Nocudo/Pendulo-Furuta-Control-Digital/cad/01_pendulo_furuta/renders/render_corte_articulacion.png

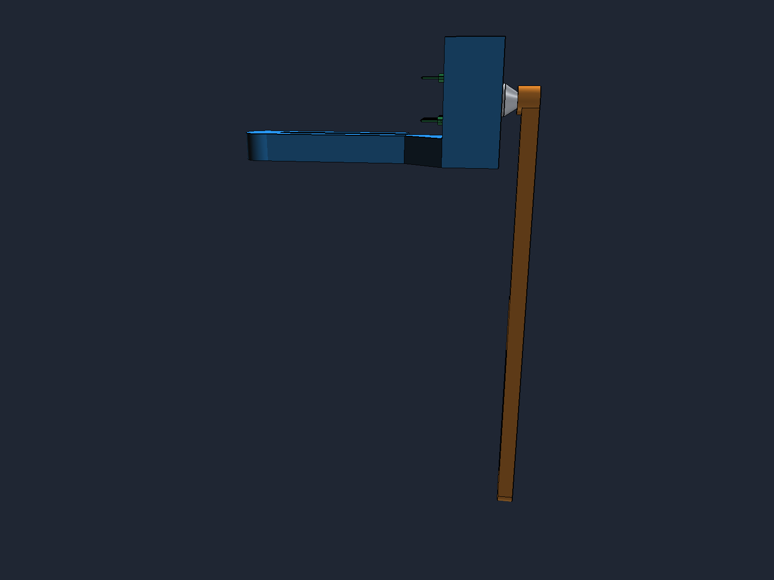
cad/01_pendulo_furuta/renders/render_corte_articulacion.png
