Nocudo/Pendulo-Furuta-Control-Digital/cad/01_pendulo_furuta/renders/render_corte_torre_motor.png

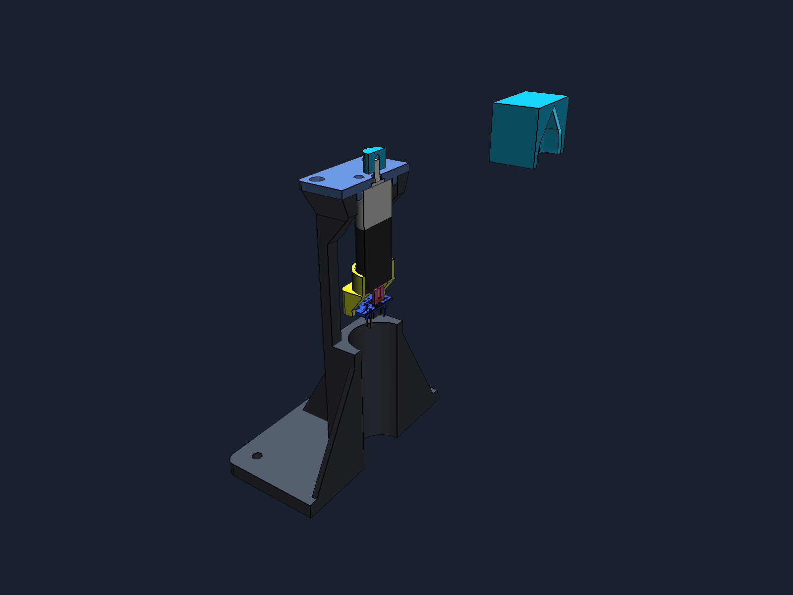
cad/01_pendulo_furuta/renders/render_corte_torre_motor.png
