Nocudo/Pendulo-Furuta-Control-Digital/cad/01_pendulo_furuta/renders/render_despiece_furuta.png

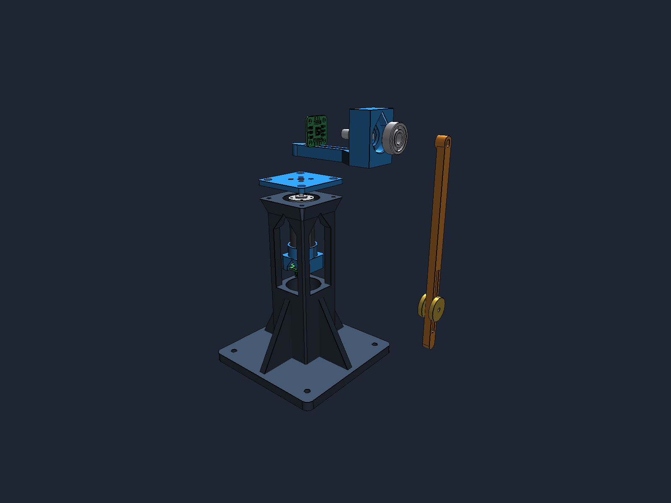
cad/01_pendulo_furuta/renders/render_despiece_furuta.png
