Nocudo/Pendulo-Furuta-Control-Digital/cad/01_pendulo_furuta/renders/render_detalle_acople_motor.png

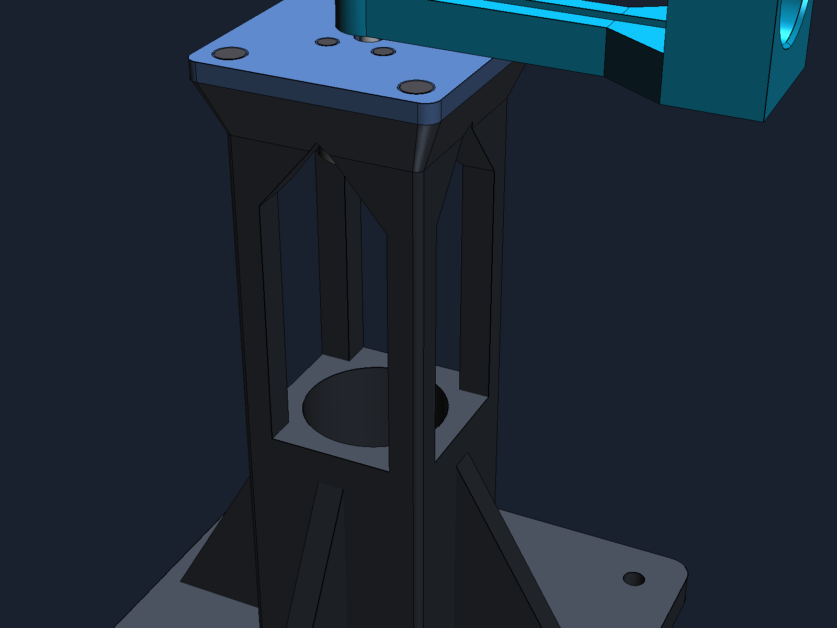
cad/01_pendulo_furuta/renders/render_detalle_acople_motor.png
