Nocudo/Pendulo-Furuta-Control-Digital/cad/01_pendulo_furuta/renders/render_detalle_articulacion.png

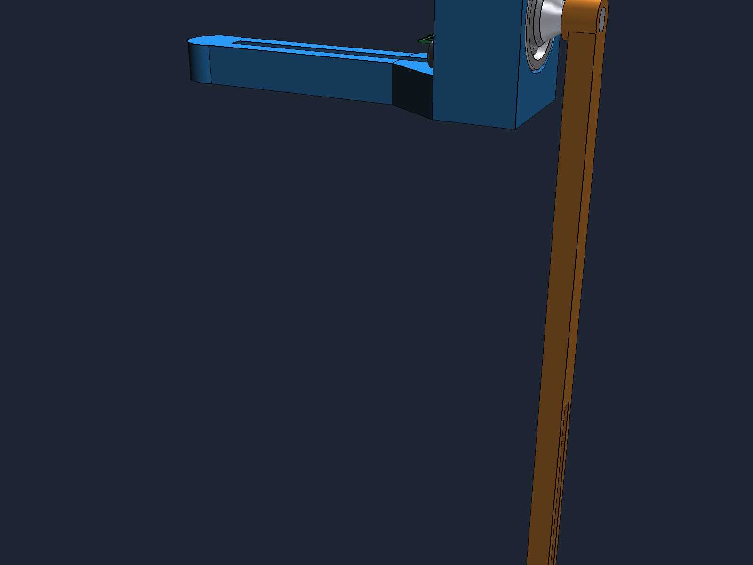
cad/01_pendulo_furuta/renders/render_detalle_articulacion.png
