Nocudo/Pendulo-Furuta-Control-Digital/cad/01_pendulo_furuta/renders/render_detalle_sensor_pendulo.png

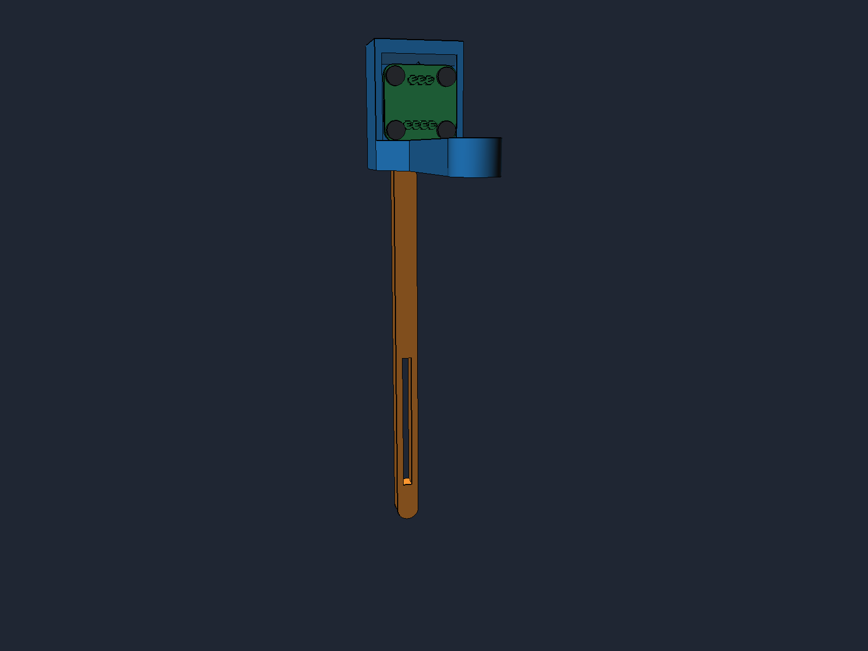
cad/01_pendulo_furuta/renders/render_detalle_sensor_pendulo.png
