Nocudo/Pendulo-Furuta-Control-Digital/cad/01_pendulo_furuta/renders/render_pendulo_furuta_completo.png

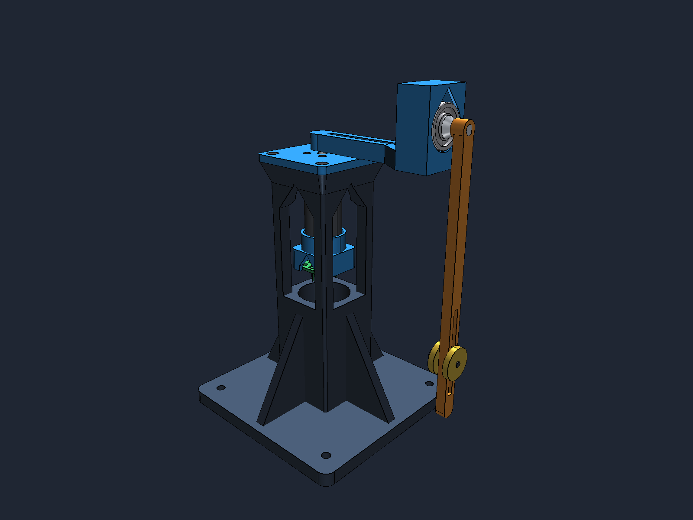
cad/01_pendulo_furuta/renders/render_pendulo_furuta_completo.png
