Nocudo/Pendulo-Furuta-Control-Digital/cad/01_pendulo_furuta/renders/render_vista_lateral.png

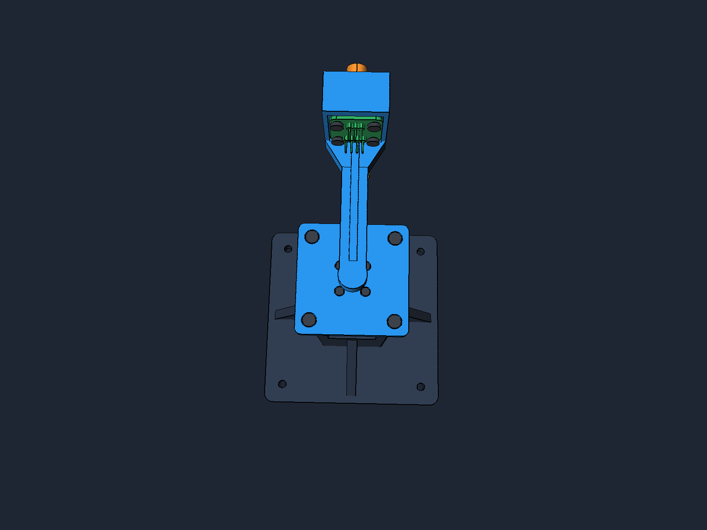
cad/01_pendulo_furuta/renders/render_vista_lateral.png
