Nocudo/Pendulo-Furuta-Control-Digital/cad/01_pendulo_furuta/renders/render_vista_lateral_completa.png

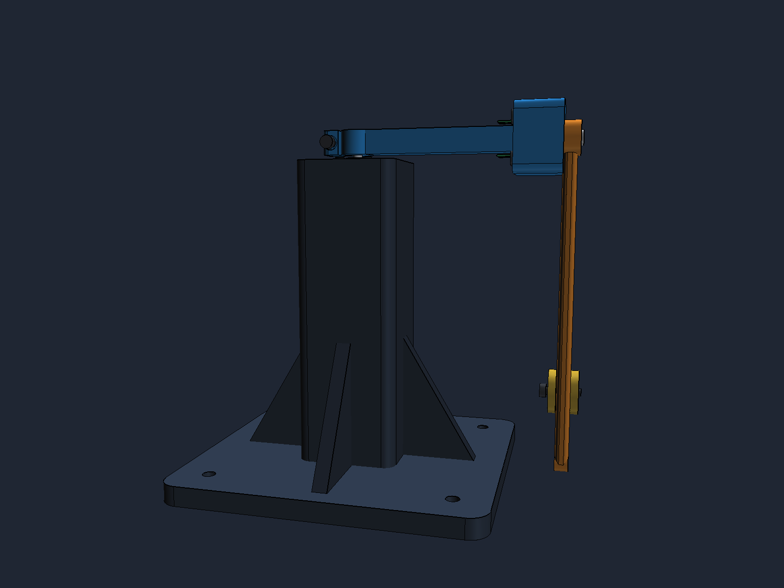
cad/01_pendulo_furuta/renders/render_vista_lateral_completa.png
