Nocudo/Pendulo-Furuta-Control-Digital/cad/02_motor_namiki_as5600/renders/render_acoplador_3d.png

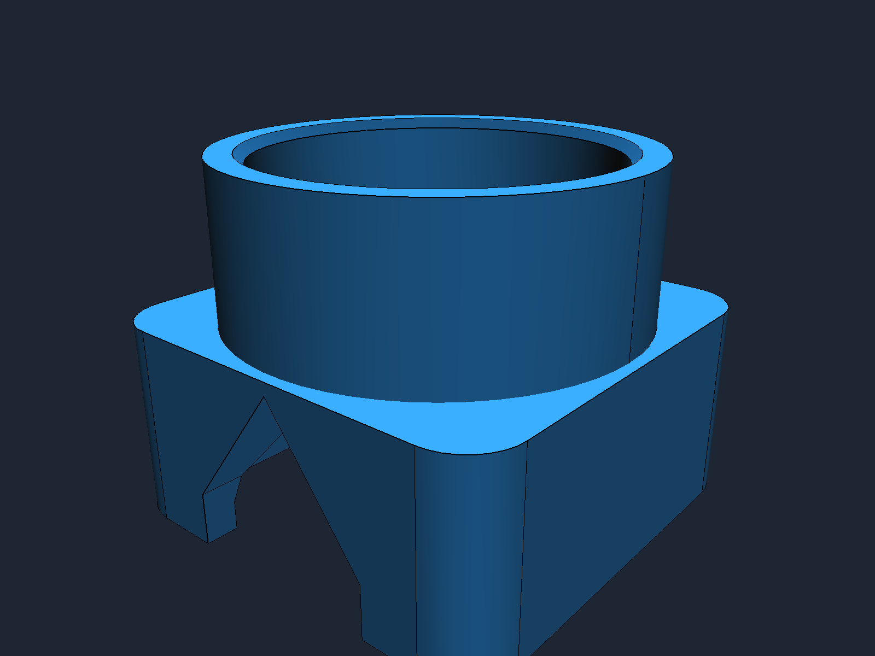
cad/02_motor_namiki_as5600/renders/render_acoplador_3d.png
