Nocudo/Pendulo-Furuta-Control-Digital/cad/02_motor_namiki_as5600/renders/render_corte_transversal.png

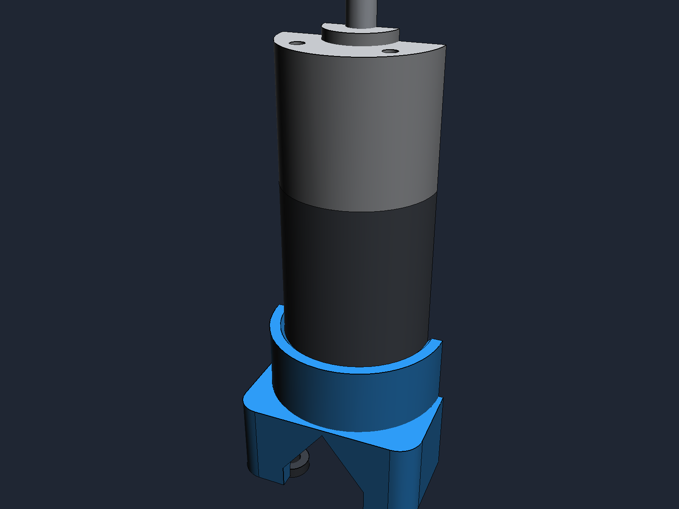
cad/02_motor_namiki_as5600/renders/render_corte_transversal.png
