Nocudo/Pendulo-Furuta-Control-Digital/cad/02_motor_namiki_as5600/renders/render_vista_inferior_pcb.png

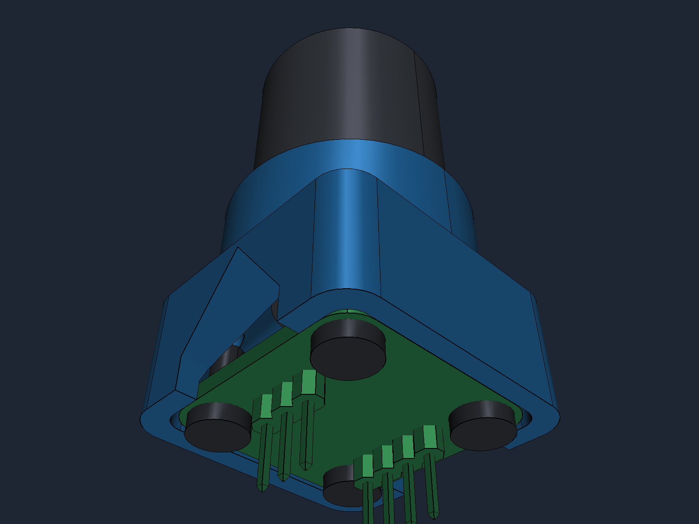
cad/02_motor_namiki_as5600/renders/render_vista_inferior_pcb.png
