Nocudo/Pendulo-Furuta-Control-Digital/cad/03_caja_nucleo_f446re/renders/render_caja_nucleo_detalle_conexiones.png

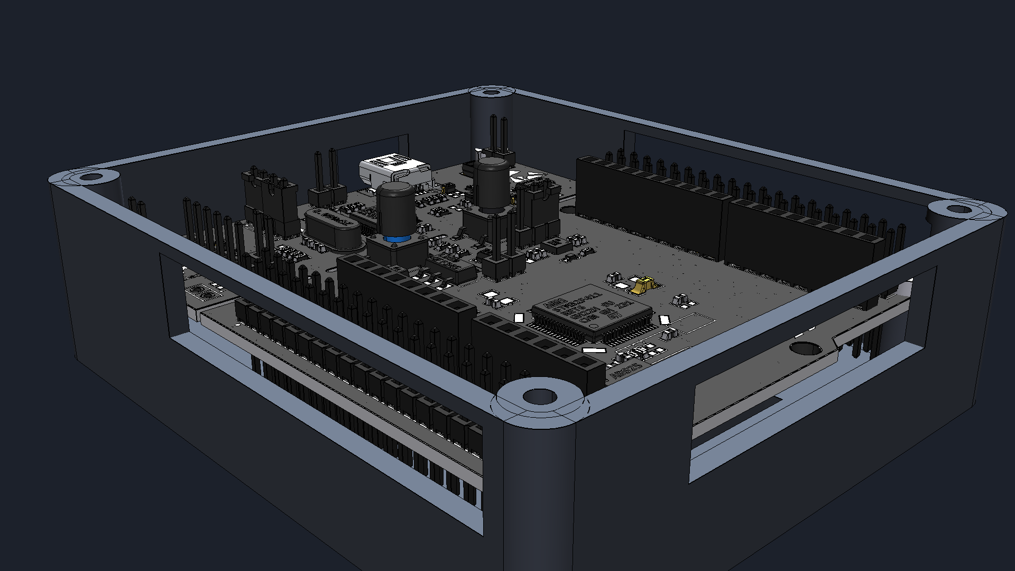
cad/03_caja_nucleo_f446re/renders/render_caja_nucleo_detalle_conexiones.png
