Nocudo/Pendulo-Furuta-Control-Digital/cad/03_caja_nucleo_f446re/renders/render_caja_nucleo_inferior.png

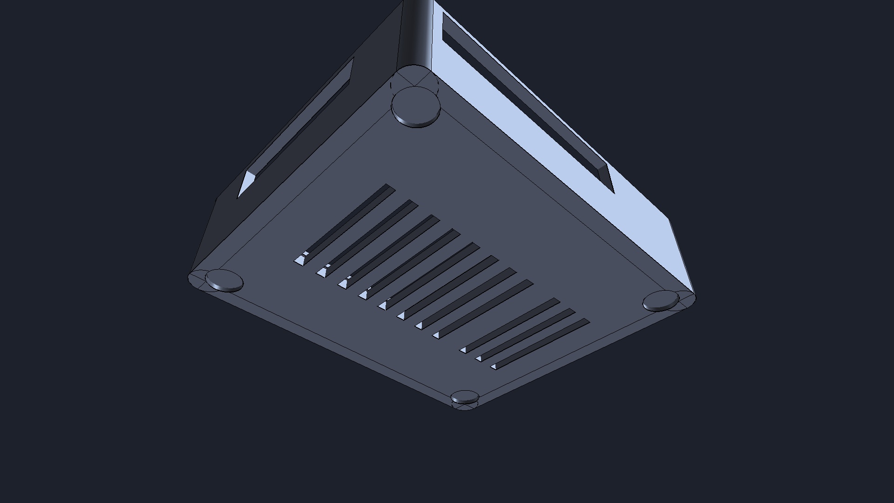
cad/03_caja_nucleo_f446re/renders/render_caja_nucleo_inferior.png
