Nocudo/Pendulo-Furuta-Control-Digital/cad/04_caja_driver_l298n/renders/render_caja_l298n_detalle_conexiones.png

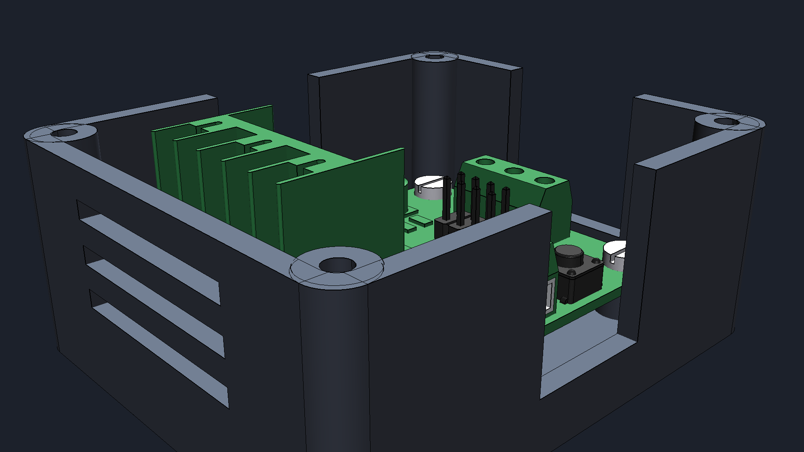
cad/04_caja_driver_l298n/renders/render_caja_l298n_detalle_conexiones.png
