Nocudo/Pendulo-Furuta-Control-Digital/cad/referencias/rodamiento_608_as5600/Assimbly.png

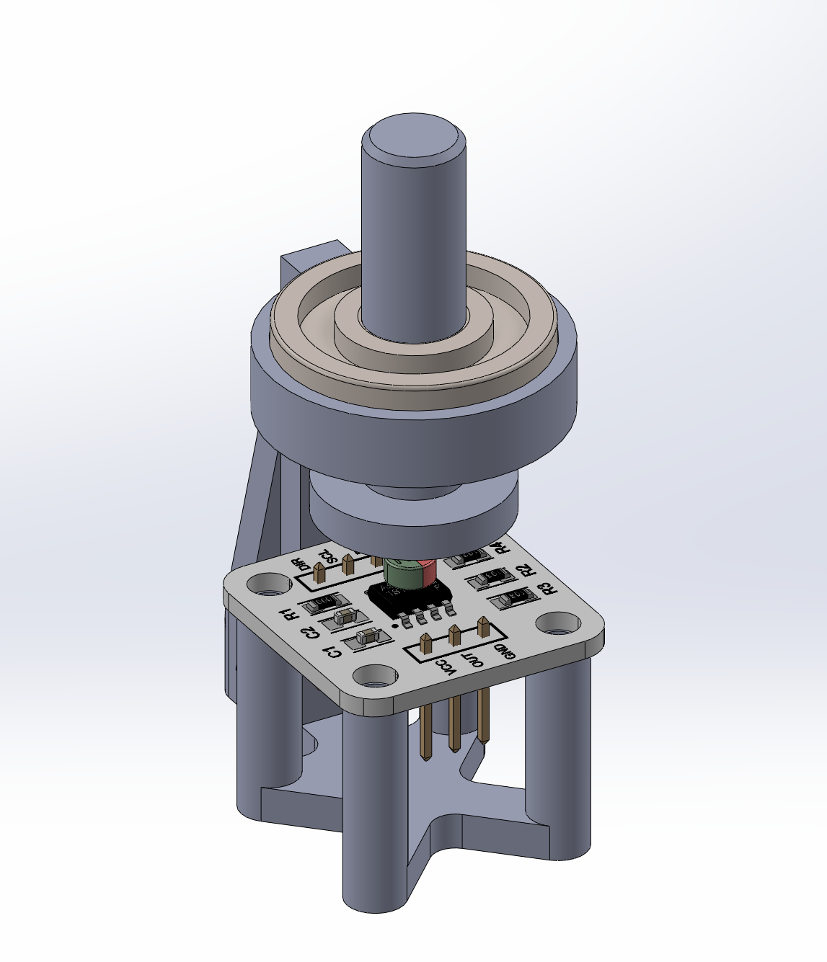
cad/referencias/rodamiento_608_as5600/Assimbly.png
