Nocudo/Pendulo-Furuta-Control-Digital/cad/referencias/tornillo_punta_redonda/tornillo_render.png

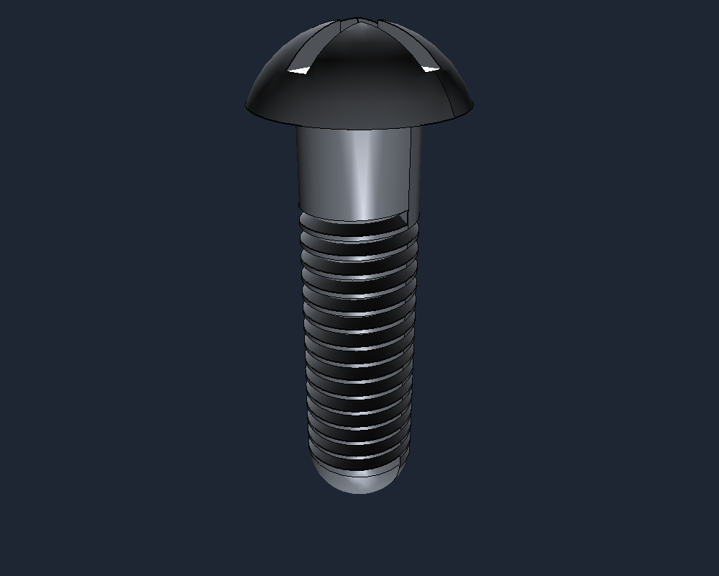
cad/referencias/tornillo_punta_redonda/tornillo_render.png
