Nocudo/Pendulo-Furuta-Control-Digital/cad/referencias/motor_22cl_3501pg/22CL-3501PG.SLDASM

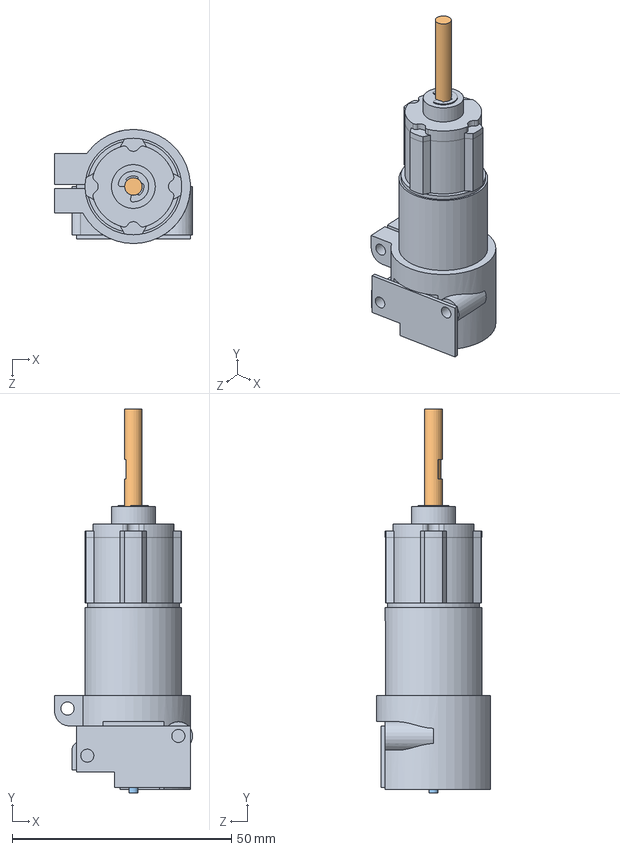
[picture p34: CAD file, 2026-11-11]
cad/referencias/motor_22cl_3501pg/22CL-3501PG.SLDASM
31.5 x 87.5 x 26.0 mm
N_1
N_2
N_3
