Nocudo/Pendulo-Furuta-Control-Digital/cad/04_caja_driver_l298n/Caja_L298N_Completa_Assembly.step

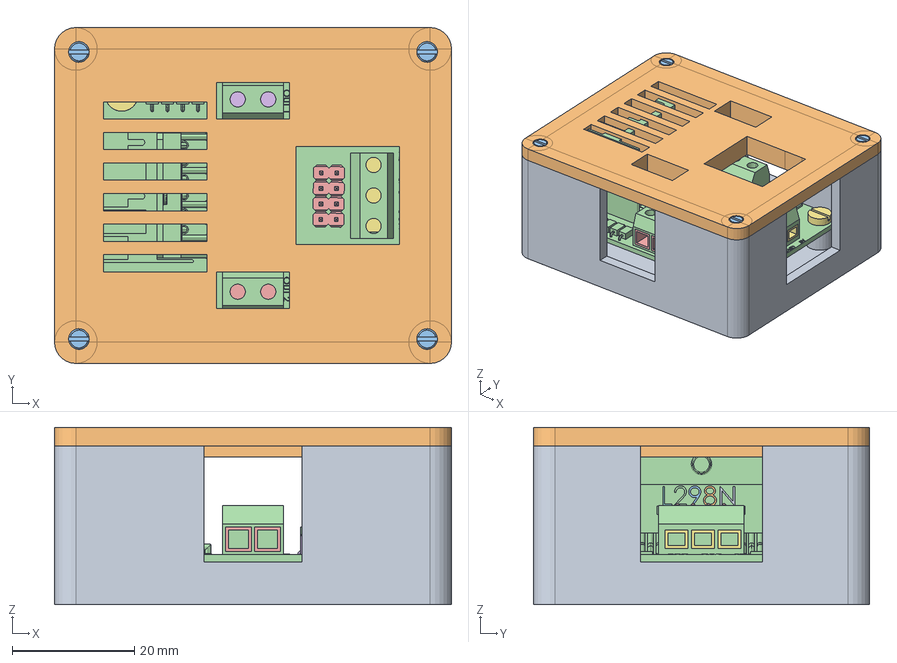
[picture p35: CAD file, 2026-11-11]
cad/04_caja_driver_l298n/Caja_L298N_Completa_Assembly.step
65.0 x 55.0 x 29.0 mm
