Nocudo/Pendulo-Furuta-Control-Digital/cad/02_motor_namiki_as5600/Motor_22CL_AS5600_Assembly.step

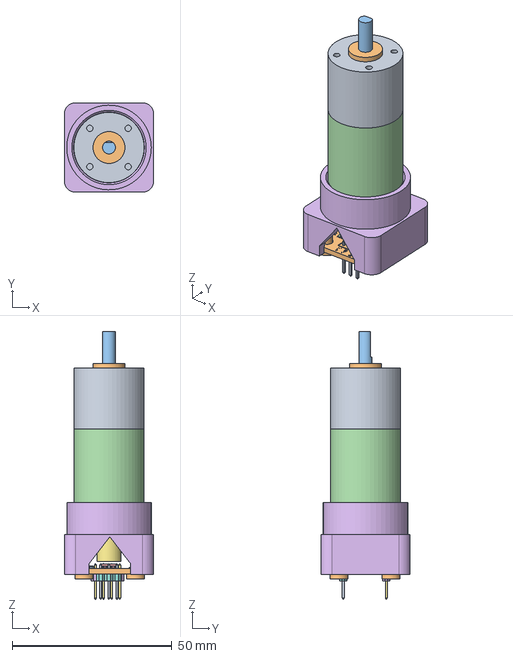
[picture p36: CAD file, 2026-11-11]
cad/02_motor_namiki_as5600/Motor_22CL_AS5600_Assembly.step
28.0 x 28.0 x 83.9 mm
