Nocudo/Pendulo-Furuta-Control-Digital/cad/referencias/rodamiento_608_as5600/ASSembly.STEP

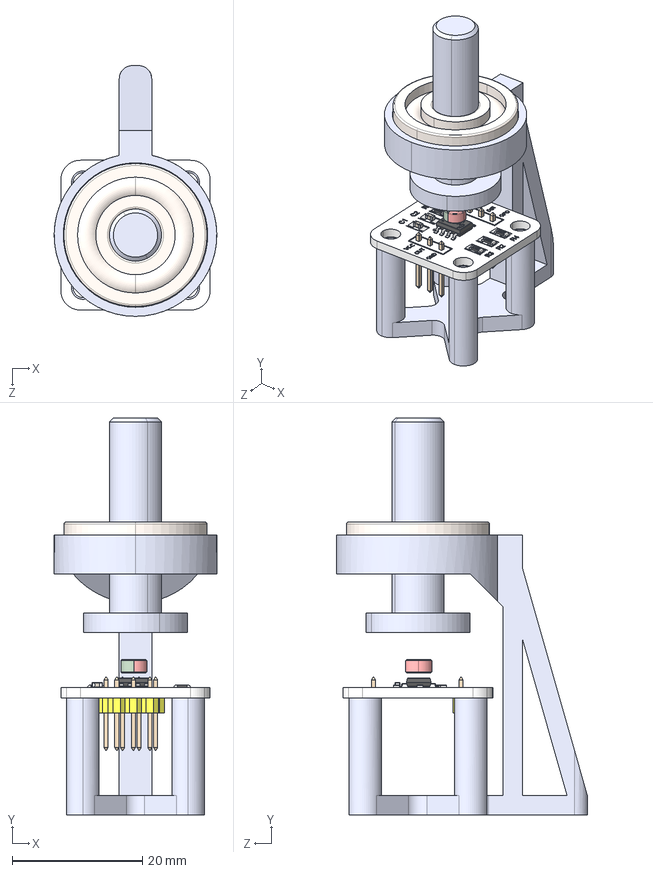
[picture p37: CAD file, 2026-11-11]
cad/referencias/rodamiento_608_as5600/ASSembly.STEP
25.0 x 61.0 x 38.5 mm
base
PCB Geometry.stp
txt.stp
bay.stp
AS5600 Geometry.stp
pin.stp
102 Geometry.stp
pin2.stp
103 Geometry.stp x 2
pin3.stp x 2
000 Geometry.stp
pin4.stp
C Geometry.stp x 2
Pin5.stp x 2
4Pin Geometry.stp
PIN6.stp
3Pin Geometry.stp
pin7.stp
Magnet.stp
instrument ball bearing_68_iso_ISO 1224 - 100822 - R,8,SI,NC,8_68
stick
