Nocudo/Pendulo-Furuta-Control-Digital/cad/05_caja_esp32/Caja_ESP32_Completa_Assembly.step

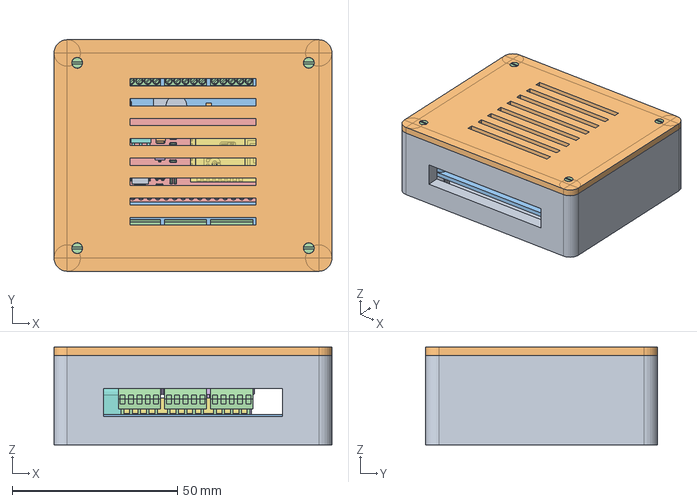
[picture p38: CAD file, 2026-11-11]
cad/05_caja_esp32/Caja_ESP32_Completa_Assembly.step
84.0 x 70.0 x 29.5 mm
