Nocudo/Pendulo-Furuta-Control-Digital/cad/01_pendulo_furuta/Pendulo_Furuta_Assembly.step

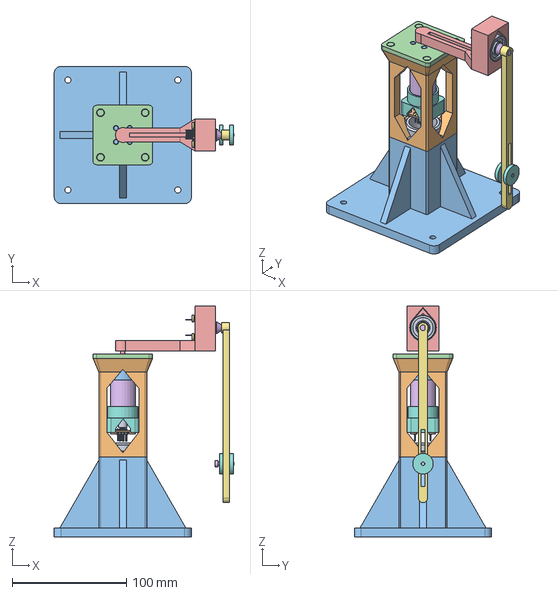
[picture p39: CAD file, 2026-11-12]
cad/01_pendulo_furuta/Pendulo_Furuta_Assembly.step
156.9 x 120.0 x 201.8 mm
