Nocudo/Pendulo-Furuta-Control-Digital/cad/01_pendulo_furuta/Barra_Pendulo_Furuta.step

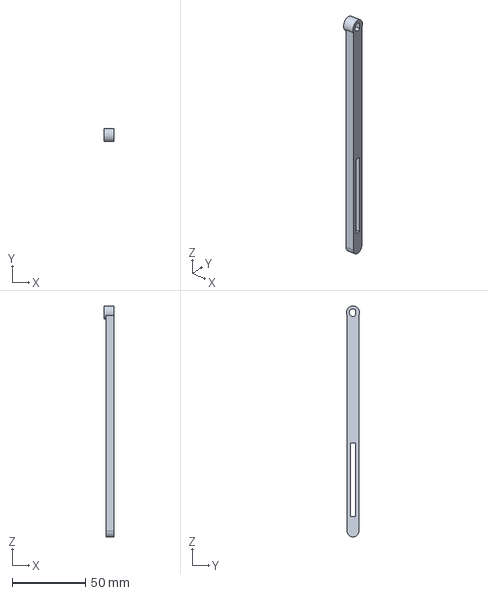
[picture p40: CAD file, 2026-11-12]
cad/01_pendulo_furuta/Barra_Pendulo_Furuta.step
7.00 x 9.00 x 157.3 mm
