Nocudo/Pendulo-Furuta-Control-Digital/cad/04_caja_driver_l298n/User Library-L298n-4.STEP

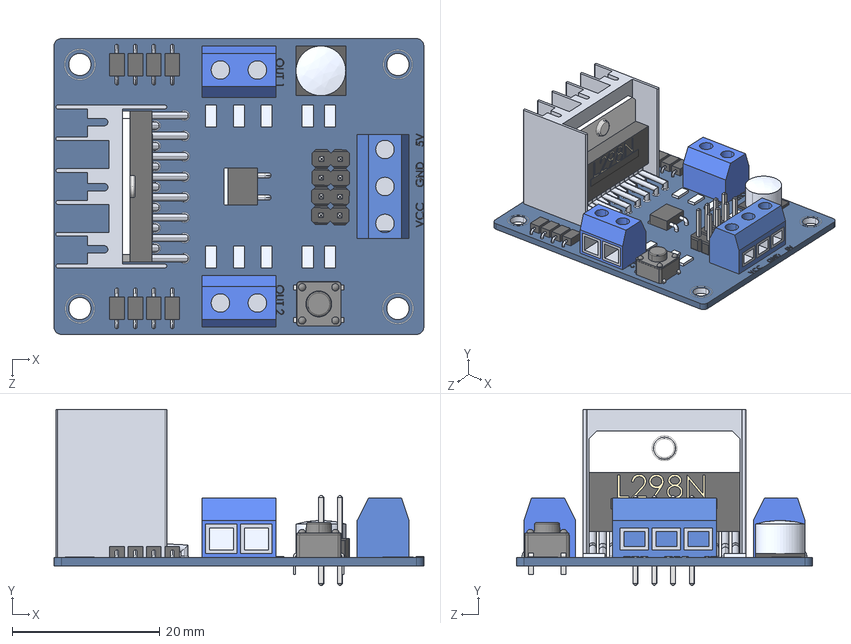
[picture p41: CAD file, 2026-11-11]
cad/04_caja_driver_l298n/User Library-L298n-4.STEP
50.0 x 23.8 x 40.0 mm
l298n
HDR2x4
Tact DIP 6x6
