Nocudo/Pendulo-Furuta-Control-Digital/cad/referencias/rodamiento_608_as5600/archivos/stick_7,95mm.STL

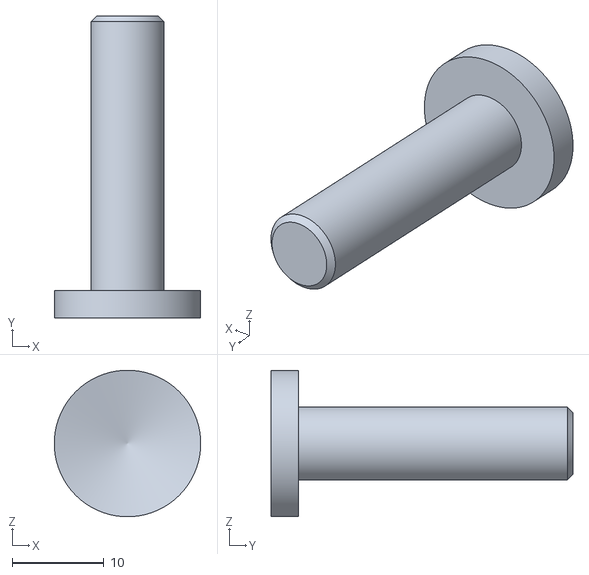
[picture p42: CAD file, 2026-11-11]
cad/referencias/rodamiento_608_as5600/archivos/stick_7,95mm.STL
16.0 x 33.0 x 16.0
