Nocudo/Pendulo-Furuta-Control-Digital/cad/referencias/rodamiento_608_as5600/AS5600_Testing_Stand_Clean.step

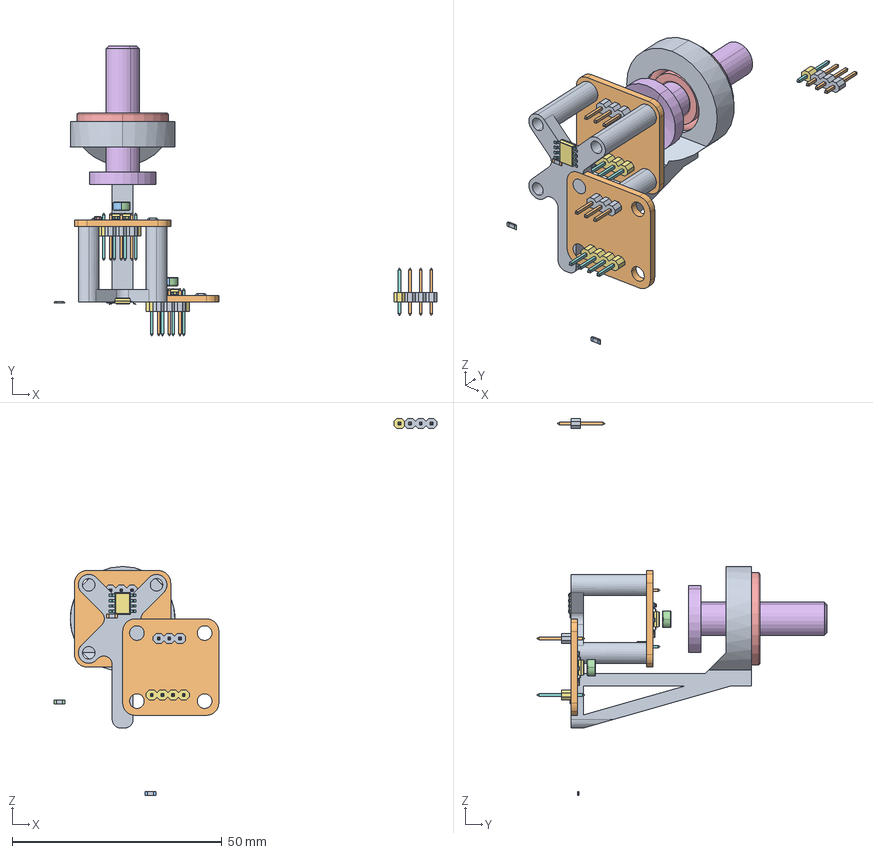
[picture p43: CAD file, 2026-11-11]
cad/referencias/rodamiento_608_as5600/AS5600_Testing_Stand_Clean.step
91.4 x 69.1 x 90.0 mm
