Nocudo/Pendulo-Furuta-Control-Digital/cad/referencias/tornillo_punta_redonda/tornillo_punta_redonda.step

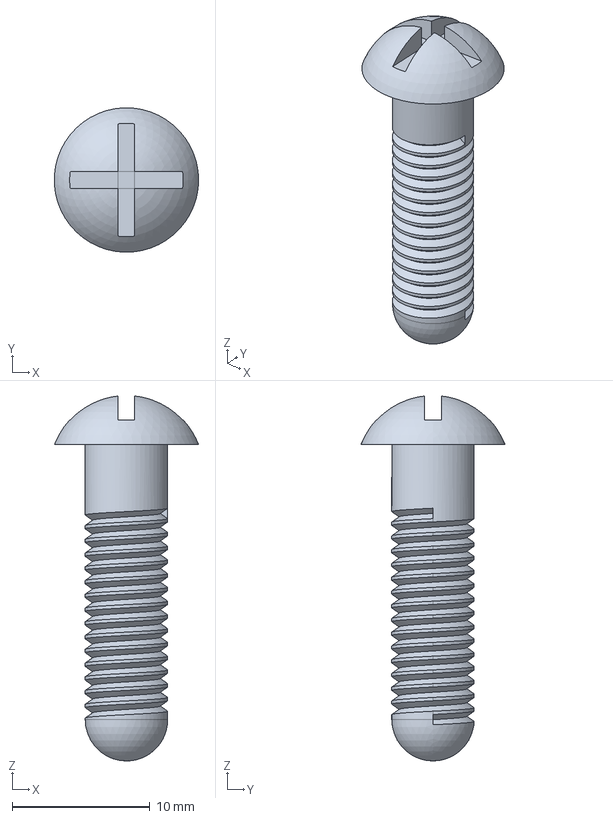
[picture p44: CAD file, 2026-11-11]
cad/referencias/tornillo_punta_redonda/tornillo_punta_redonda.step
10.5 x 10.5 x 26.5 mm
