Nocudo/Pendulo-Furuta-Control-Digital/IMPRESION_3D/02_Pendulo_Furuta/Masa_Ajustable_Pendulo.step

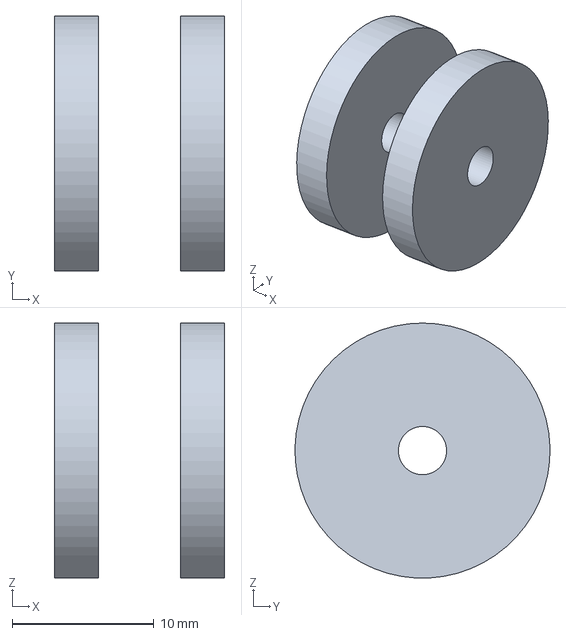
[picture p45: CAD file, 2026-11-12]
IMPRESION_3D/02_Pendulo_Furuta/Masa_Ajustable_Pendulo.step
12.0 x 18.0 x 18.0 mm
