Nocudo/Pendulo-Furuta-Control-Digital/IMPRESION_3D/Placas_Cura_Listas/Proyectos_3MF/Placa_2_Torre_Superior_Motor.3mf

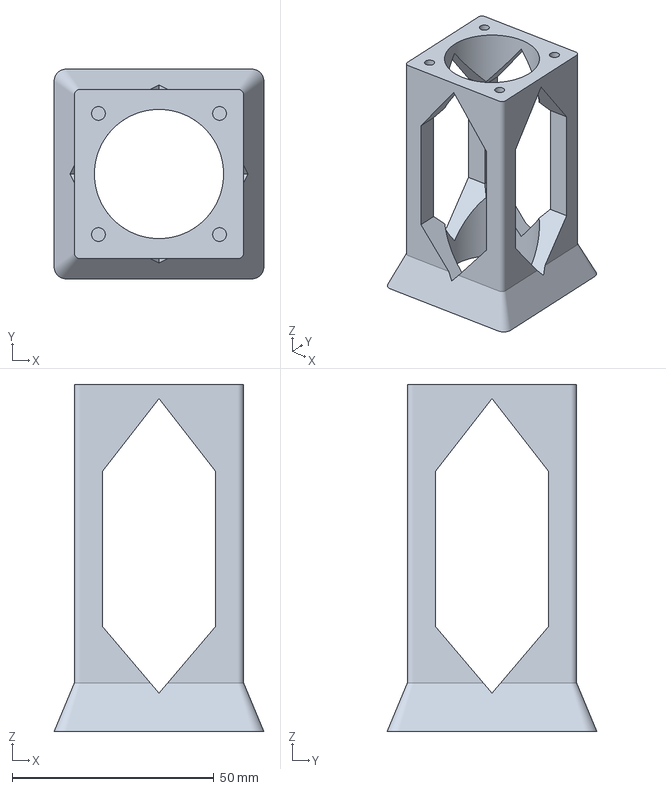
[picture p46: CAD file, 2026-11-12]
IMPRESION_3D/Placas_Cura_Listas/Proyectos_3MF/Placa_2_Torre_Superior_Motor.3mf
52.0 x 52.0 x 86.0 mm
