Nocudo/Pendulo-Furuta-Control-Digital/cad/01_pendulo_furuta/Base_Torre_Furuta.step

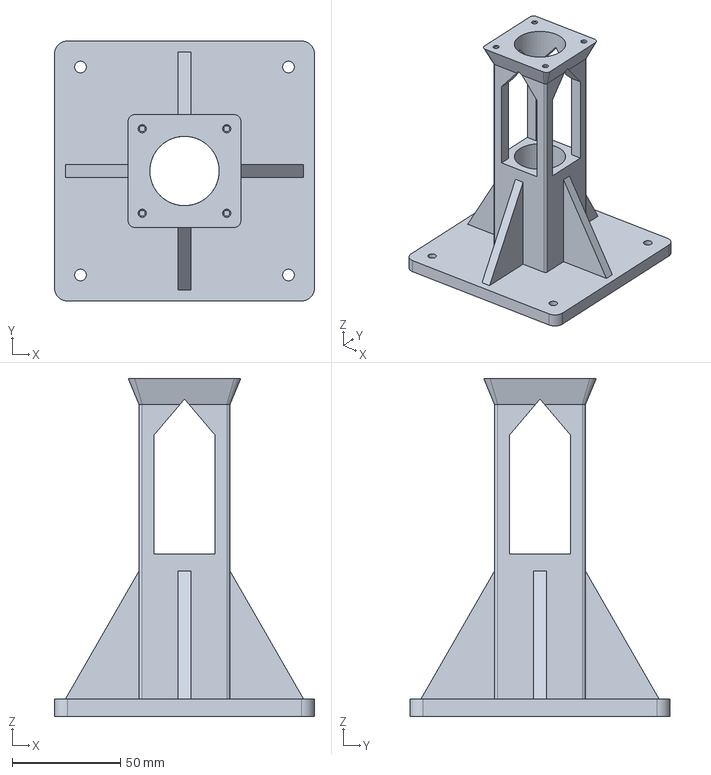
[picture p47: CAD file, 2026-11-12]
cad/01_pendulo_furuta/Base_Torre_Furuta.step
120.0 x 120.0 x 156.0 mm
