Nocudo/Pendulo-Furuta-Control-Digital/cad/02_motor_namiki_as5600/Portaiman_AS5600.step

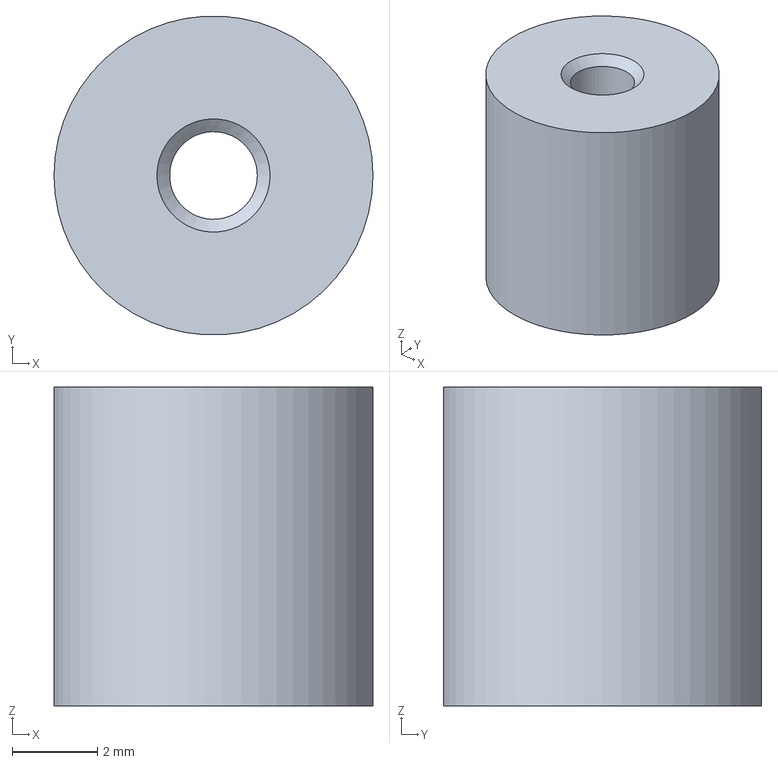
[picture p48: CAD file, 2026-11-11]
cad/02_motor_namiki_as5600/Portaiman_AS5600.step
7.50 x 7.49 x 7.50 mm
