Nocudo/Pendulo-Furuta-Control-Digital/cad/05_caja_esp32/components/expansion_board_esp32_shield_CAD.step

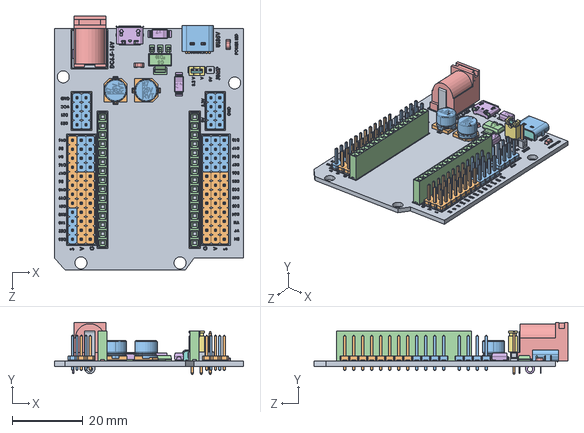
[picture p49: CAD file, 2026-11-11]
cad/05_caja_esp32/components/expansion_board_esp32_shield_CAD.step
53.4 x 14.8 x 71.7 mm
