Nocudo/Pendulo-Furuta-Control-Digital/cad/05_caja_esp32/Tapa_Caja_ESP32.step

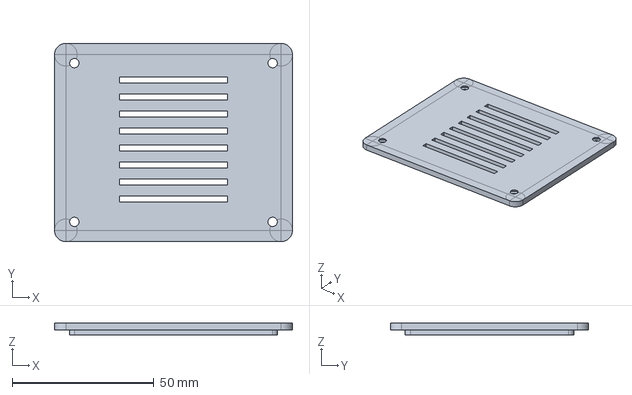
[picture p50: CAD file, 2026-11-11]
cad/05_caja_esp32/Tapa_Caja_ESP32.step
84.0 x 70.0 x 4.30 mm
