Nocudo/Pendulo-Furuta-Control-Digital/cad/referencias/motor_22cl_3501pg/Namiki_22CL_3501PG.step

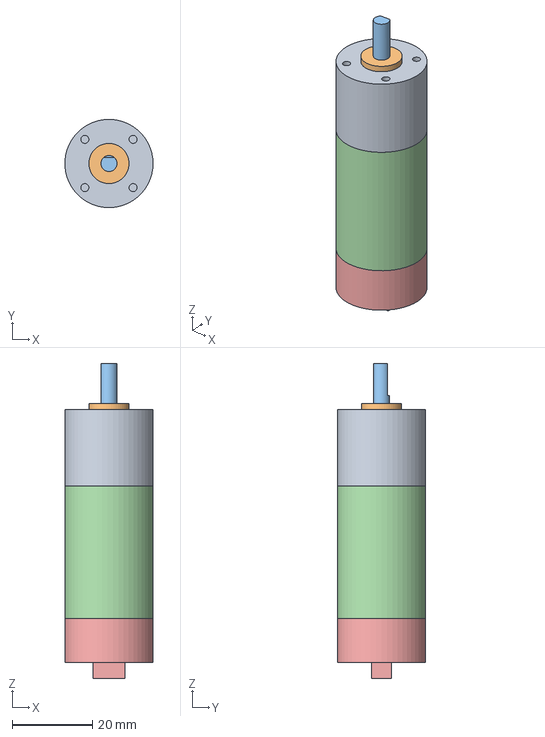
[picture p51: CAD file, 2026-11-11]
cad/referencias/motor_22cl_3501pg/Namiki_22CL_3501PG.step
22.0 x 22.0 x 78.5 mm
