Nocudo/Pendulo-Furuta-Control-Digital/cad/referencias/rodamiento_608_as5600/base.SLDPRT

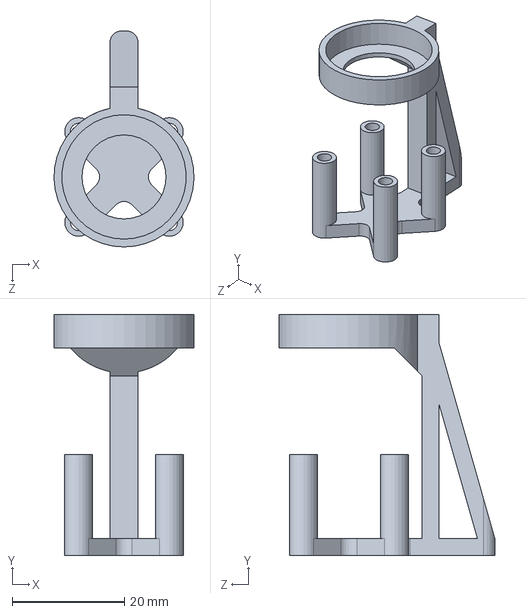
[picture p52: CAD file, 2026-11-11]
cad/referencias/rodamiento_608_as5600/base.SLDPRT
25.0 x 43.0 x 38.5 mm
