Nocudo/Pendulo-Furuta-Control-Digital/IMPRESION_3D/02_Pendulo_Furuta/Tapa_Motor_Torre_Furuta.step

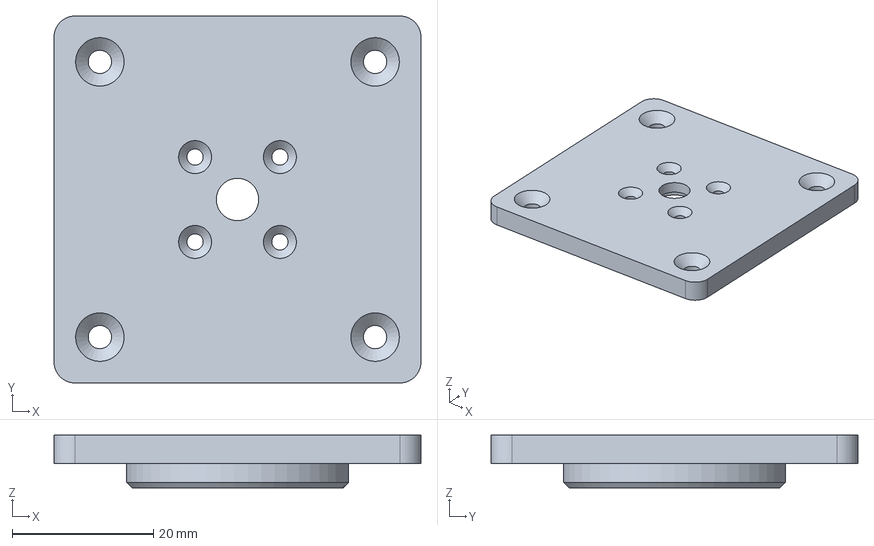
[picture p53: CAD file, 2026-11-12]
IMPRESION_3D/02_Pendulo_Furuta/Tapa_Motor_Torre_Furuta.step
52.0 x 52.0 x 7.50 mm
