Nocudo/Pendulo-Furuta-Control-Digital/IMPRESION_3D/Placas_Cura_Listas/Proyectos_3MF/Placa_1_Base_Inferior_Torre.3mf

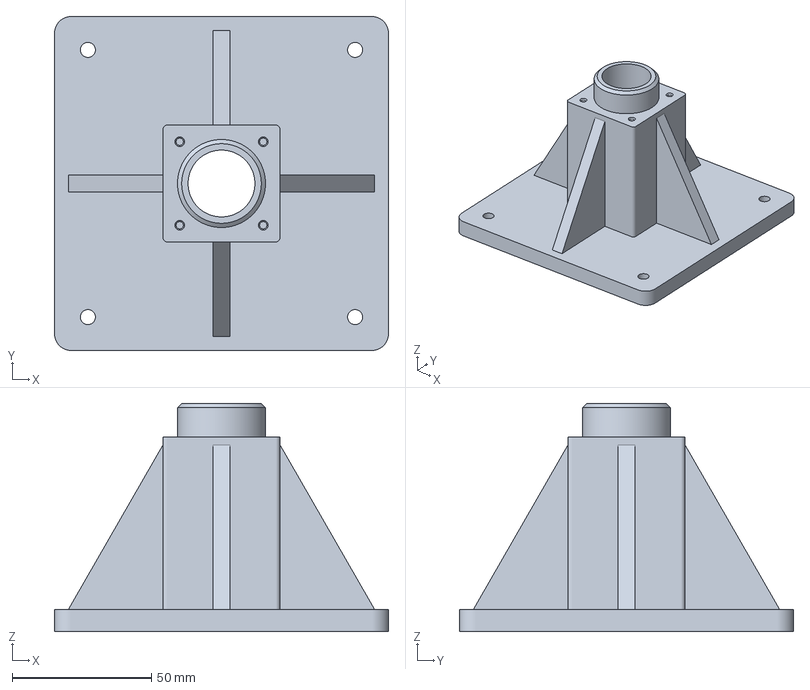
[picture p54: CAD file, 2026-11-12]
IMPRESION_3D/Placas_Cura_Listas/Proyectos_3MF/Placa_1_Base_Inferior_Torre.3mf
120.0 x 120.0 x 82.0 mm
