Nocudo/Pendulo-Furuta-Control-Digital/cad/05_caja_esp32/components/15-Pin Header - Female - 2.54mm.step

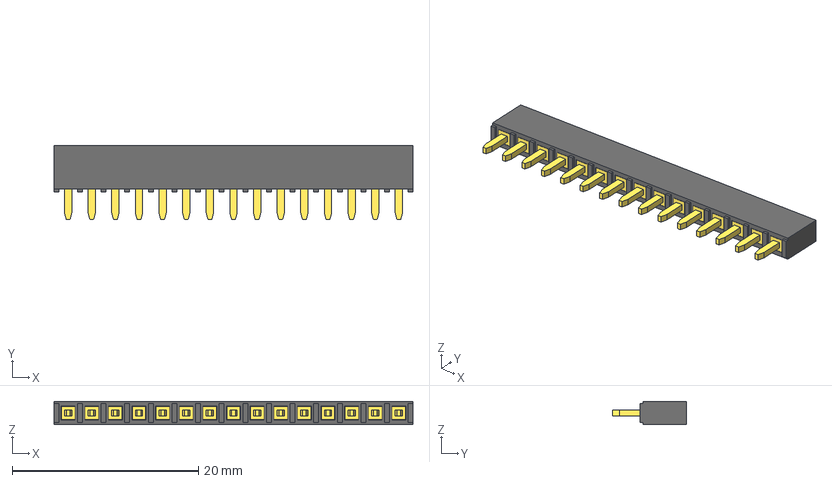
[picture p55: CAD file, 2026-11-11]
cad/05_caja_esp32/components/15-Pin Header - Female - 2.54mm.step
38.6 x 8.00 x 2.50 mm
