Nocudo/Pendulo-Furuta-Control-Digital/cad/05_caja_esp32/Placa_ESP32_Expansion_Real.step

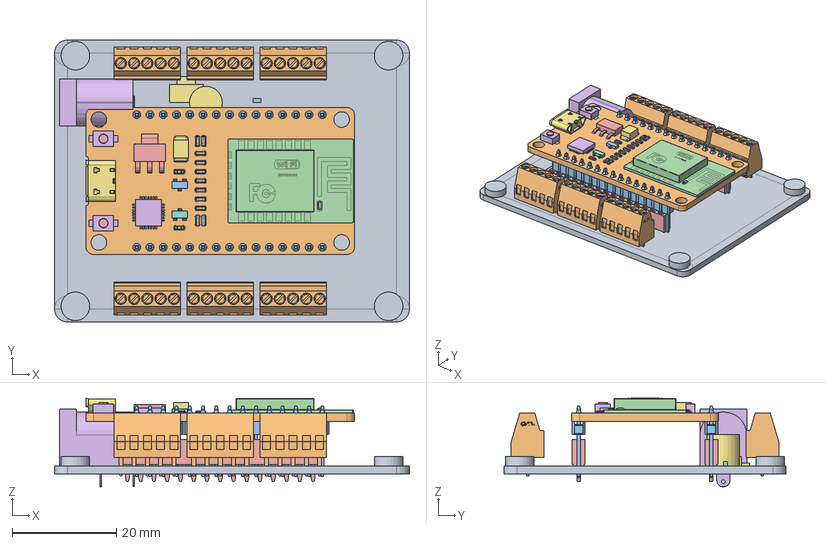
[picture p56: CAD file, 2026-11-11]
cad/05_caja_esp32/Placa_ESP32_Expansion_Real.step
68.0 x 54.0 x 17.0 mm
