Nocudo/Pendulo-Furuta-Control-Digital/IMPRESION_3D/02_Pendulo_Furuta/Brazo_Horizontal_L88.step

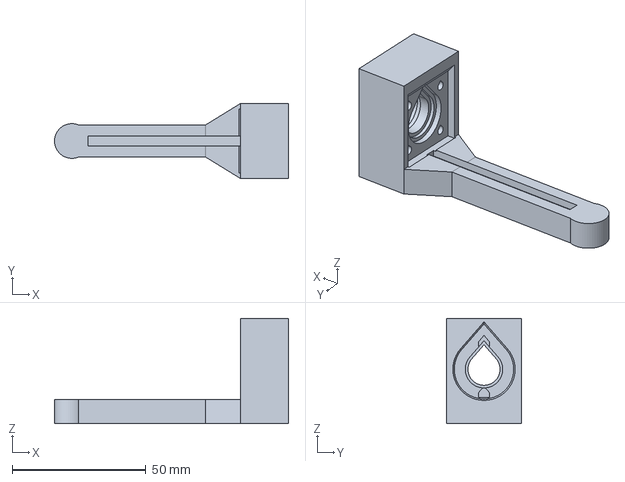
[picture p57: CAD file, 2026-11-12]
IMPRESION_3D/02_Pendulo_Furuta/Brazo_Horizontal_L88.step
87.5 x 28.0 x 39.3 mm
