Nocudo/Pendulo-Furuta-Control-Digital/IMPRESION_3D/Placas_Cura_Listas/Proyectos_3MF/Placa_6_Caja_L298N.3mf

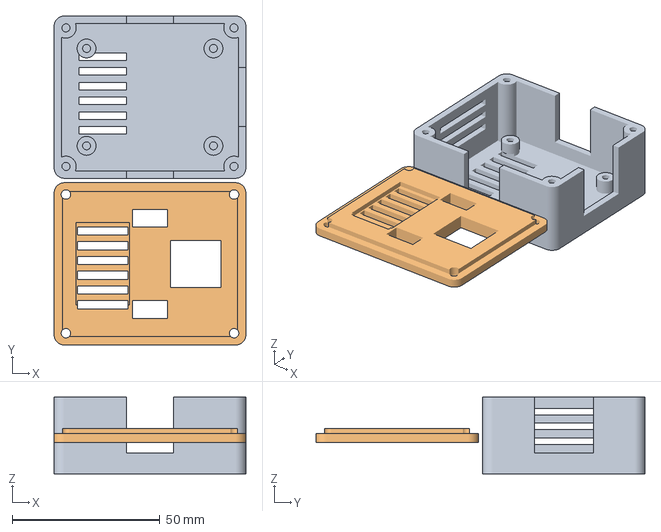
[picture p58: CAD file, 2026-11-12]
IMPRESION_3D/Placas_Cura_Listas/Proyectos_3MF/Placa_6_Caja_L298N.3mf
65.0 x 111.5 x 26.0 mm
Caja_Base_L298N.stl
Tapa_Caja_L298N.stl
