Nocudo/Pendulo-Furuta-Control-Digital/cad/02_motor_namiki_as5600/Acoplador_Motor_AS5600.step

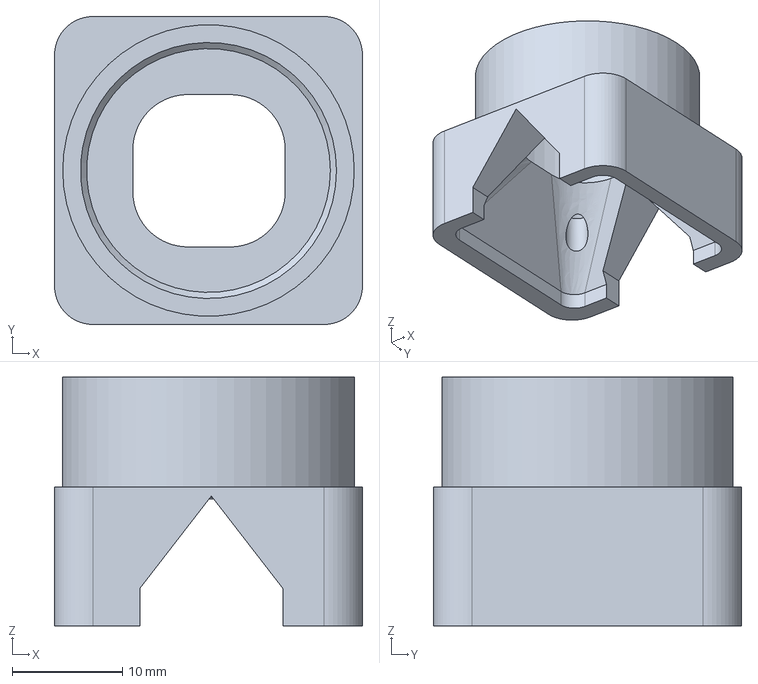
[picture p59: CAD file, 2026-11-11]
cad/02_motor_namiki_as5600/Acoplador_Motor_AS5600.step
28.0 x 28.0 x 22.6 mm
