Nocudo/Pendulo-Furuta-Control-Digital/cad/03_caja_nucleo_f446re/Caja_Nucleo_F401.FCStd

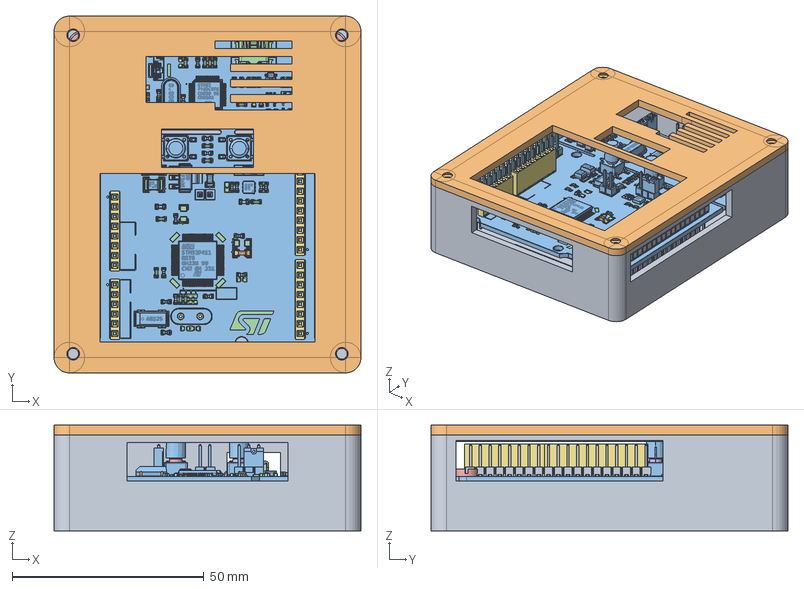
[picture p60: CAD file, 2026-11-11]
cad/03_caja_nucleo_f446re/Caja_Nucleo_F401.FCStd
80.0 x 93.0 x 27.5 mm
Caja Base (Chasis con Rejilla Inferior y Ventanas Pasantes)
Tapa Superior Ventilada (Ventanas Conexiones y Pulsadores)
Nucleo-64 - PCB FR4 Blanco Oficial ST
Nucleo-64 - Puerto USB ST-LINK Acero Inoxidable
Nucleo-64 - Botón B1 USER Azul Eléctrico
Nucleo-64 - Botón B2 RESET Negro Mate
Nucleo-64 - Zócalos Hembra Arduino Uno V3
Nucleo-64 - Conector Morpho Izquierdo CN7 (2x19 Pines)
Nucleo-64 - Conector Morpho Derecho CN10 (2x19 Pines)
Nucleo-64 - Pines Macho Dorados/Estañados
Nucleo-64 - STM32F401RE y Chips Silicio
Nucleo-64 - Pasivos SMD y Serigrafía Oficial
Tornillos M3 Fijación Placa a Separadores
