Nocudo/Pendulo-Furuta-Control-Digital/cad/04_caja_driver_l298n/Driver_L298N_Real.step

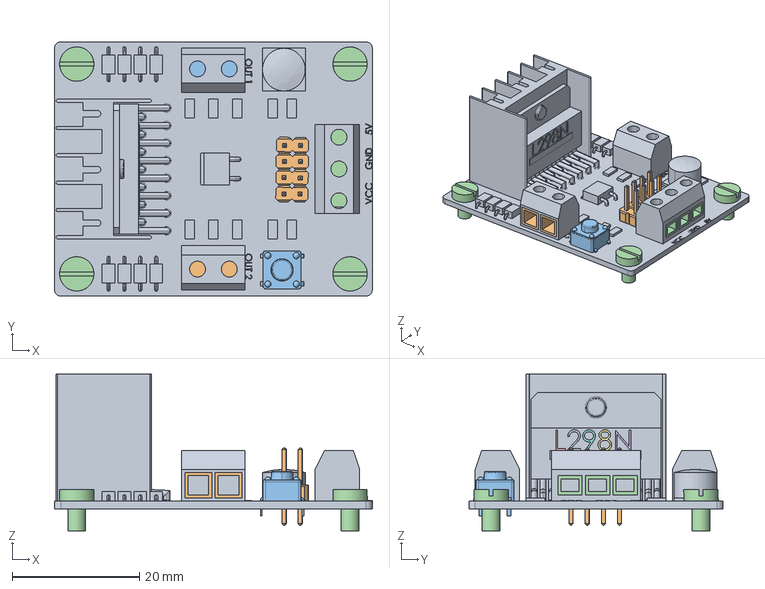
[picture p61: CAD file, 2026-11-11]
cad/04_caja_driver_l298n/Driver_L298N_Real.step
50.0 x 40.0 x 24.7 mm
