Nocudo/Pendulo-Furuta-Control-Digital/cad/05_caja_esp32/Caja_Base_ESP32.step

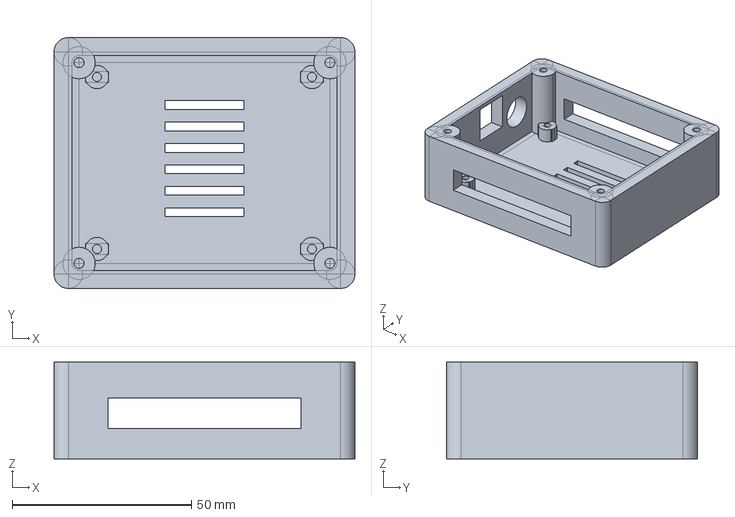
[picture p62: CAD file, 2026-11-11]
cad/05_caja_esp32/Caja_Base_ESP32.step
84.0 x 70.0 x 27.0 mm
