Nocudo/Pendulo-Furuta-Control-Digital/cad/05_caja_esp32/components/3D_ESP32_Breakout_V2.step

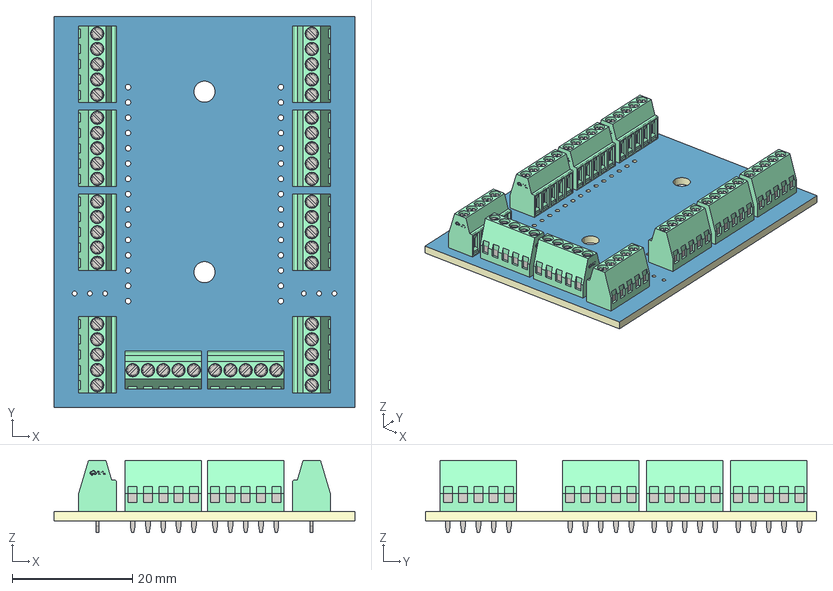
[picture p63: CAD file, 2026-11-11]
cad/05_caja_esp32/components/3D_ESP32_Breakout_V2.step
50.0 x 65.0 x 12.0 mm
Board~6faX
TopCopper~6faX
BottomCopper~6faX
TopFpcStiffener~6faX
BottomFpcStiffener~6faX
CONN-TH_DB125-2.54-5P-GN~CONN-TH_DB125-2.54-5P-GN~6faX x 10
