Nocudo/Pendulo-Furuta-Control-Digital/IMPRESION_3D/02_Pendulo_Furuta/Eje_Portaiman_Pendulo.step

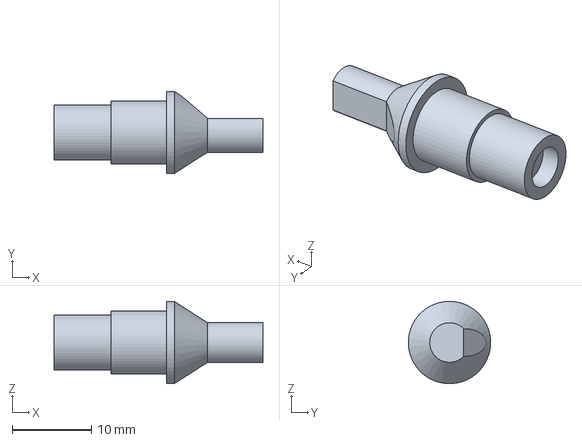
[picture p64: CAD file, 2026-11-12]
IMPRESION_3D/02_Pendulo_Furuta/Eje_Portaiman_Pendulo.step
26.4 x 10.4 x 10.4 mm
