Nocudo/Pendulo-Furuta-Control-Digital/IMPRESION_3D/Placas_Cura_Listas/Proyectos_3MF/Placa_5_Caja_Nucleo.3mf

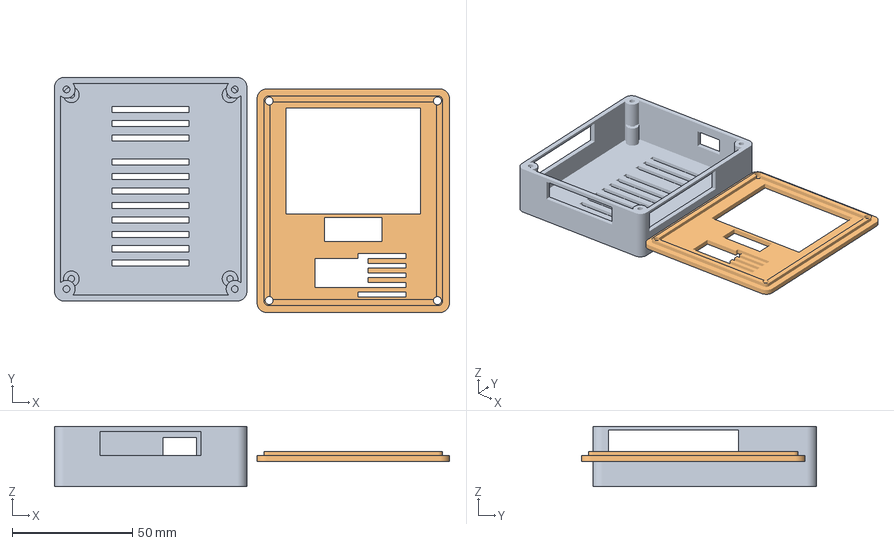
[picture p65: CAD file, 2026-11-12]
IMPRESION_3D/Placas_Cura_Listas/Proyectos_3MF/Placa_5_Caja_Nucleo.3mf
164.3 x 97.8 x 25.0 mm
Caja_Base_Nucleo.stl
Tapa_Caja_Nucleo.stl
