Nocudo/Pendulo-Furuta-Control-Digital/cad/03_caja_nucleo_f446re/Caja_Base_Nucleo.step

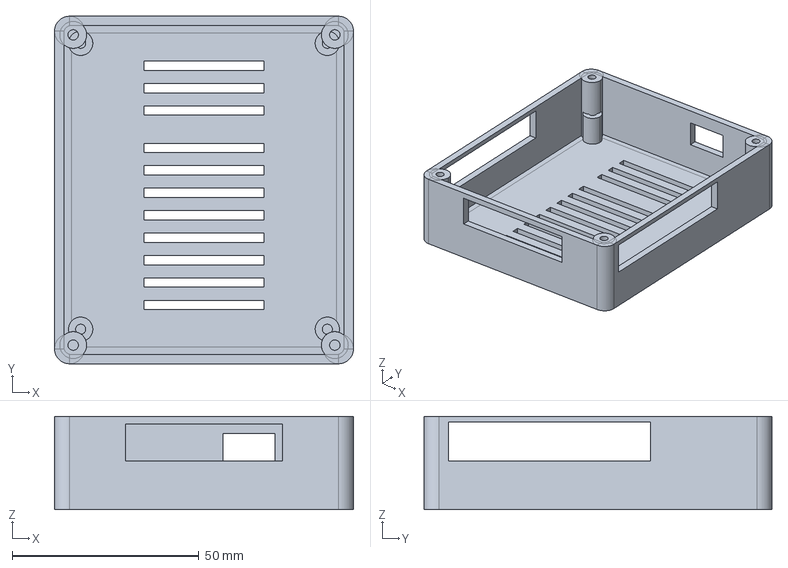
[picture p66: CAD file, 2026-11-11]
cad/03_caja_nucleo_f446re/Caja_Base_Nucleo.step
80.0 x 93.0 x 25.0 mm
