Nocudo/Pendulo-Furuta-Control-Digital/cad/04_caja_driver_l298n/Tapa_Caja_L298N.step

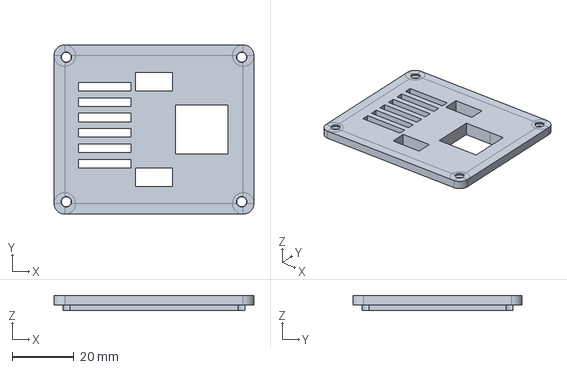
[picture p67: CAD file, 2026-11-11]
cad/04_caja_driver_l298n/Tapa_Caja_L298N.step
65.0 x 55.0 x 4.80 mm
