Nocudo/Pendulo-Furuta-Control-Digital/cad/05_caja_esp32/components/DG306-5.0-15P-12-00AH.step

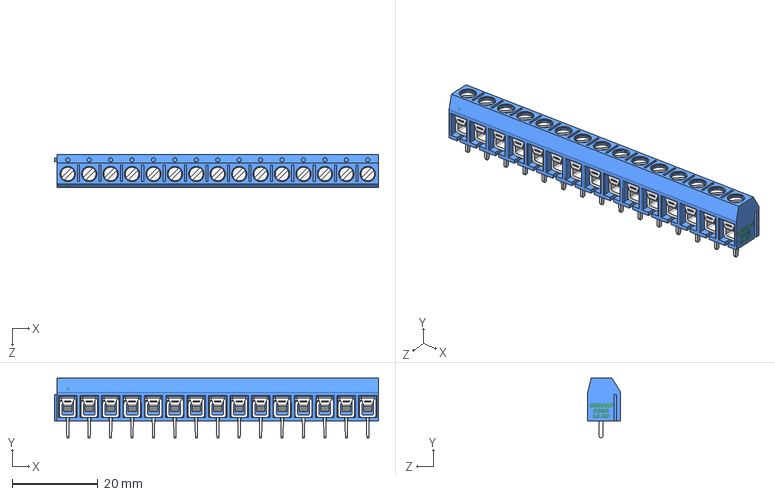
[picture p68: CAD file, 2026-11-11]
cad/05_caja_esp32/components/DG306-5.0-15P-12-00AH.step
75.6 x 13.9 x 7.60 mm
