Nocudo/Pendulo-Furuta-Control-Digital/IMPRESION_3D/Placas_Cura_Listas/Proyectos_3MF/Placa_7_Caja_ESP32.3mf

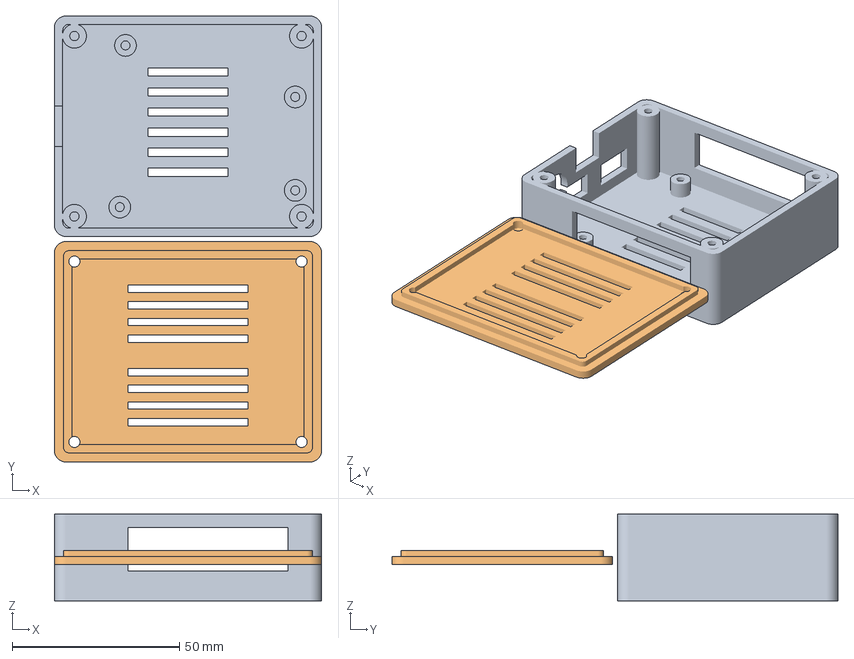
[picture p69: CAD file, 2026-11-12]
IMPRESION_3D/Placas_Cura_Listas/Proyectos_3MF/Placa_7_Caja_ESP32.3mf
80.0 x 133.5 x 26.0 mm
Caja_Base_ESP32.stl
Tapa_Caja_ESP32.stl
