Nocudo/Pendulo-Furuta-Control-Digital/cad/03_caja_nucleo_f446re/Tapa_Caja_Nucleo.step

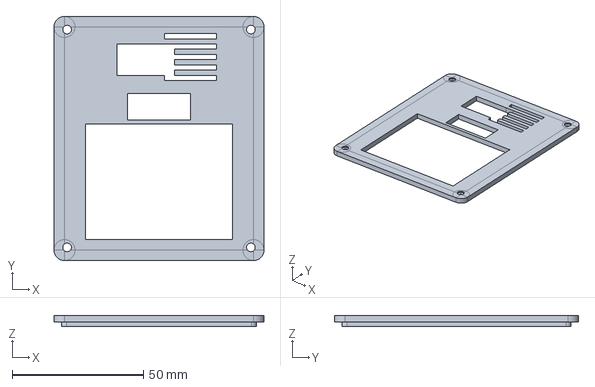
[picture p70: CAD file, 2026-11-11]
cad/03_caja_nucleo_f446re/Tapa_Caja_Nucleo.step
80.0 x 93.0 x 4.30 mm
