Nocudo/Pendulo-Furuta-Control-Digital/cad/04_caja_driver_l298n/Caja_Base_L298N.step

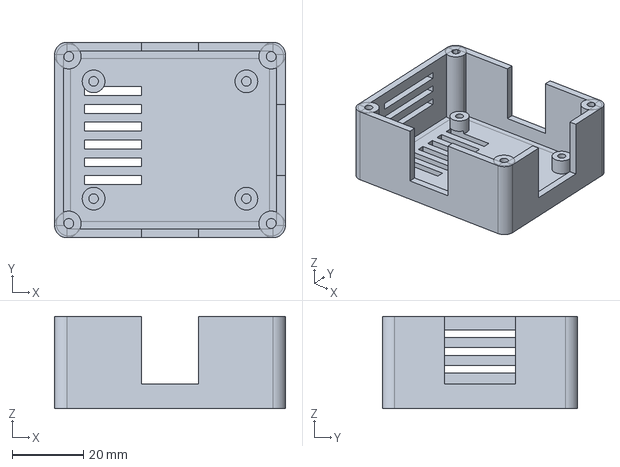
[picture p71: CAD file, 2026-11-11]
cad/04_caja_driver_l298n/Caja_Base_L298N.step
65.0 x 55.0 x 26.0 mm
