Nocudo/Pendulo-Furuta-Control-Digital/cad/05_caja_esp32/components/BarrelJack.step

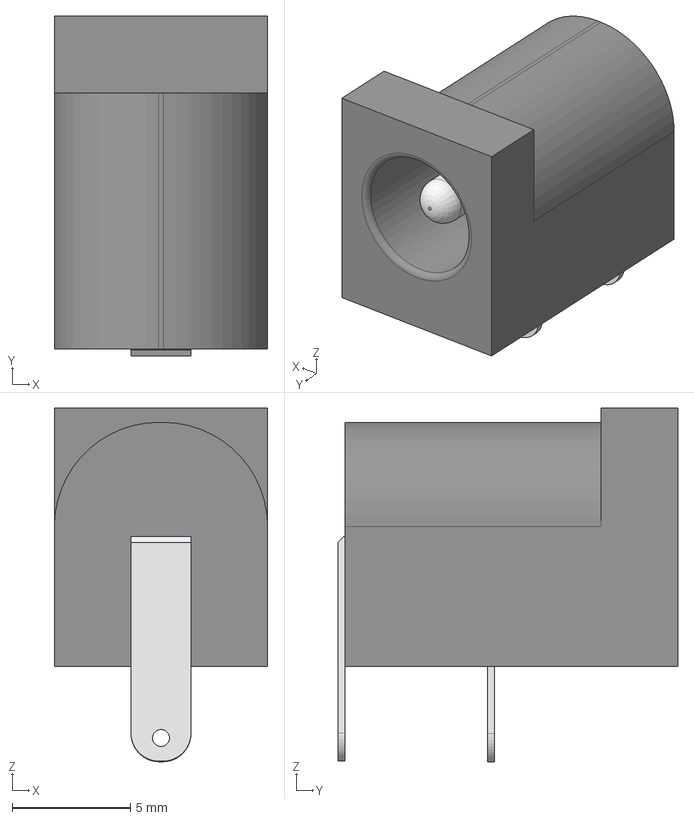
[picture p72: CAD file, 2026-11-11]
cad/05_caja_esp32/components/BarrelJack.step
9.00 x 14.4 x 14.9 mm
