Nocudo/Pendulo-Furuta-Control-Digital/IMPRESION_3D/Placas_Cura_Listas/Proyectos_3MF/Placa_4_Precision_Encoder_AS5600.3mf

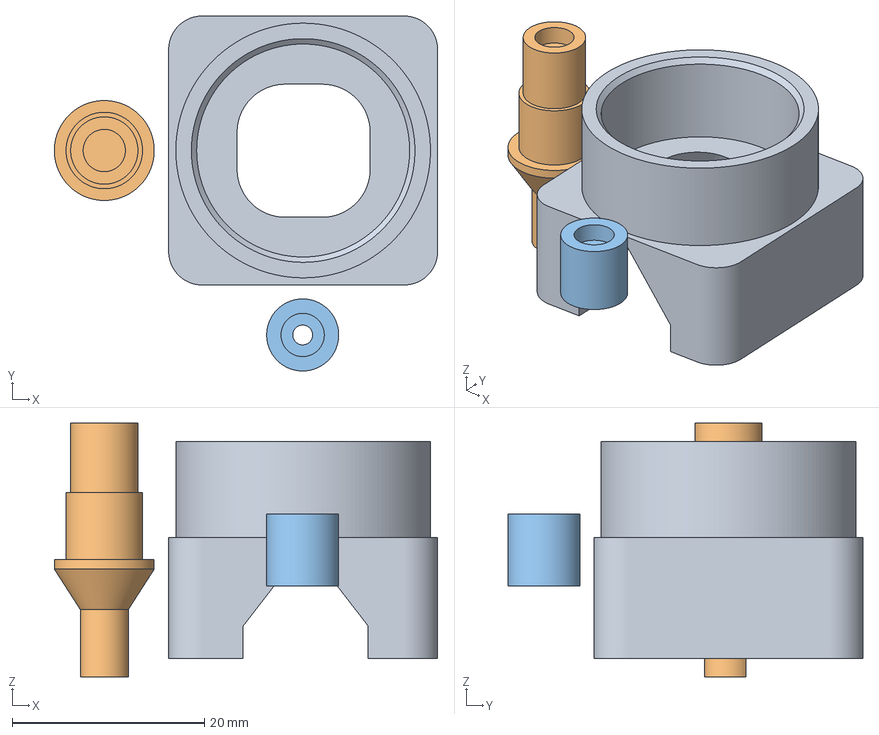
[picture p73: CAD file, 2026-11-12]
IMPRESION_3D/Placas_Cura_Listas/Proyectos_3MF/Placa_4_Precision_Encoder_AS5600.3mf
39.9 x 36.9 x 26.4 mm
Acoplador_Motor_AS5600.stl
Eje_Portaiman_Pendulo.stl
Portaiman_AS5600.stl
