Nocudo/Pendulo-Furuta-Control-Digital/IMPRESION_3D/Placas_Cura_Listas/Proyectos_3MF/Placa_3_Brazo_Barra_y_Tapa.3mf

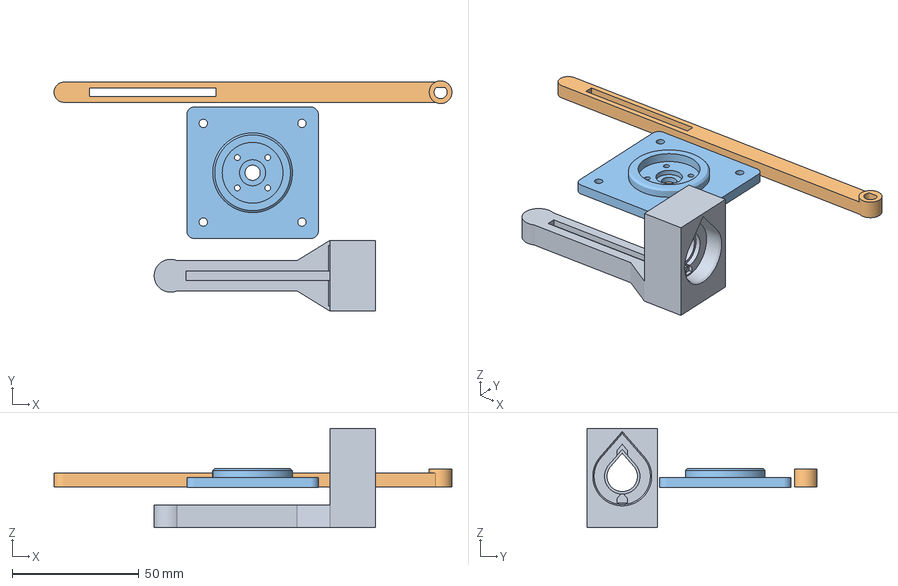
[picture p74: CAD file, 2026-11-12]
IMPRESION_3D/Placas_Cura_Listas/Proyectos_3MF/Placa_3_Brazo_Barra_y_Tapa.3mf
157.3 x 91.0 x 39.3 mm
Brazo_Horizontal_L88.stl
Barra_Pendulo_Furuta.stl
Tapa_Motor_Torre_Furuta.stl
