Nocudo/Pendulo-Furuta-Control-Digital/cad/referencias/rodamiento_608_as5600/AS5600.SLDASM

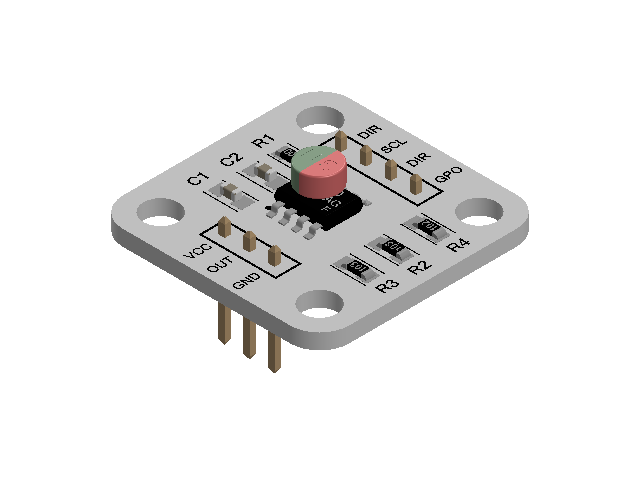
[picture p75: CAD file, 2026-11-11]
cad/referencias/rodamiento_608_as5600/AS5600.SLDASM
PCB Geometry.stp
txt.stp
bay.stp
AS5600 Geometry.stp
pin.stp
102 Geometry.stp
pin2.stp
103 Geometry.stp x 2
pin3.stp x 2
000 Geometry.stp
pin4.stp
C Geometry.stp x 2
Pin5.stp x 2
4Pin Geometry.stp
PIN6.stp
3Pin Geometry.stp
pin7.stp
Magnet.stp
