Nocudo/Pendulo-Furuta-Control-Digital/(list of files, cad)

Other CAD files:
cad/03_caja_nucleo_f446re/Caja_Nucleo_Completa_Assembly.step
cad/02_motor_namiki_as5600/Motor_22CL_AS5600.FCStd
cad/05_caja_esp32/Caja_ESP32_Expansion.FCStd
cad/03_caja_nucleo_f446re/Placa_Nucleo_F401_Real.step
cad/referencias/rodamiento_608_as5600/archivos/stick_8,00mm.STL
cad/03_caja_nucleo_f446re/NUCLEO-60-F401.STEP
cad/04_caja_driver_l298n/Caja_L298N.FCStd
cad/referencias/motor_22cl_3501pg/22CL_3501PG_Motor.FCStd
cad/referencias/rodamiento_608_as5600/archivos/base.STL
cad/referencias/rodamiento_608_as5600/AS5600_Testing_Stand.FCStd
cad/01_pendulo_furuta/Torre_Superior_Motor_Furuta.step
IMPRESION_3D/02_Pendulo_Furuta/Torre_Superior_Motor_Furuta.step
cad/01_pendulo_furuta/Pendulo_Furuta_Completo.FCStd
cad/referencias/rodamiento_608_as5600/stick.SLDPRT
IMPRESION_3D/02_Pendulo_Furuta/Base_Inferior_Torre_Furuta.step
cad/01_pendulo_furuta/Base_Inferior_Torre_Furuta.step
IMPRESION_3D/02_Pendulo_Furuta/Acoplador_Motor_AS5600.stl
IMPRESION_3D/02_Pendulo_Furuta/Barra_Pendulo_Furuta.stl
IMPRESION_3D/02_Pendulo_Furuta/Base_Inferior_Torre_Furuta.stl
IMPRESION_3D/02_Pendulo_Furuta/Base_Torre_Furuta.stl
IMPRESION_3D/02_Pendulo_Furuta/Brazo_Horizontal_L88.stl
IMPRESION_3D/02_Pendulo_Furuta/Eje_Portaiman_Pendulo.stl
IMPRESION_3D/02_Pendulo_Furuta/Masa_Ajustable_Pendulo.stl
IMPRESION_3D/02_Pendulo_Furuta/Portaiman_AS5600.stl
IMPRESION_3D/02_Pendulo_Furuta/Tapa_Motor_Torre_Furuta.stl
IMPRESION_3D/02_Pendulo_Furuta/Torre_Superior_Motor_Furuta.stl
IMPRESION_3D/04_Caja_ESP32/Caja_Base_ESP32.step
IMPRESION_3D/04_Caja_ESP32/Caja_Base_ESP32.stl
IMPRESION_3D/04_Caja_ESP32/Tapa_Caja_ESP32.step
IMPRESION_3D/04_Caja_ESP32/Tapa_Caja_ESP32.stl
cad/01_pendulo_furuta/Barra_Pendulo_Furuta.stl
cad/01_pendulo_furuta/Base_Inferior_Torre_Furuta.stl
cad/01_pendulo_furuta/Base_Torre_Furuta.stl
cad/01_pendulo_furuta/Brazo_Horizontal_L88.stl
cad/01_pendulo_furuta/Eje_Portaiman_Pendulo.stl
cad/01_pendulo_furuta/Masa_Ajustable_Pendulo.stl
cad/01_pendulo_furuta/Pendulo_Furuta_Assembly.stl
cad/01_pendulo_furuta/Tapa_Motor_Torre_Furuta.stl
cad/01_pendulo_furuta/Torre_Superior_Motor_Furuta.stl
cad/02_motor_namiki_as5600/Acoplador_Motor_AS5600.stl
cad/02_motor_namiki_as5600/Motor_22CL_AS5600_Assembly.stl
cad/02_motor_namiki_as5600/Portaiman_AS5600.stl
cad/03_caja_nucleo_f446re/Caja_Base_Nucleo.stl
cad/03_caja_nucleo_f446re/Tapa_Caja_Nucleo.stl
cad/04_caja_driver_l298n/Caja_Base_L298N.stl
cad/04_caja_driver_l298n/Tapa_Caja_L298N.stl
cad/05_caja_esp32/Caja_Base_ESP32.stl
cad/05_caja_esp32/Tapa_Caja_ESP32.stl
cad/referencias/motor_22cl_3501pg/Namiki_22CL_3501PG.FCStd
cad/referencias/motor_22cl_3501pg/Namiki_22CL_3501PG.stl
cad/referencias/rodamiento_608_as5600/AS5600_Testing_Stand_Clean.FCStd
cad/referencias/rodamiento_608_as5600/ASSembly.SLDASM
cad/referencias/tornillo_punta_redonda/tornillo_punta_redonda.FCStd
cad/referencias/tornillo_punta_redonda/tornillo_punta_redonda.stl
