Nocudo/Pendulo-Furuta-Control-Digital/cad/referencias/rodamiento_608_as5600/print example.png

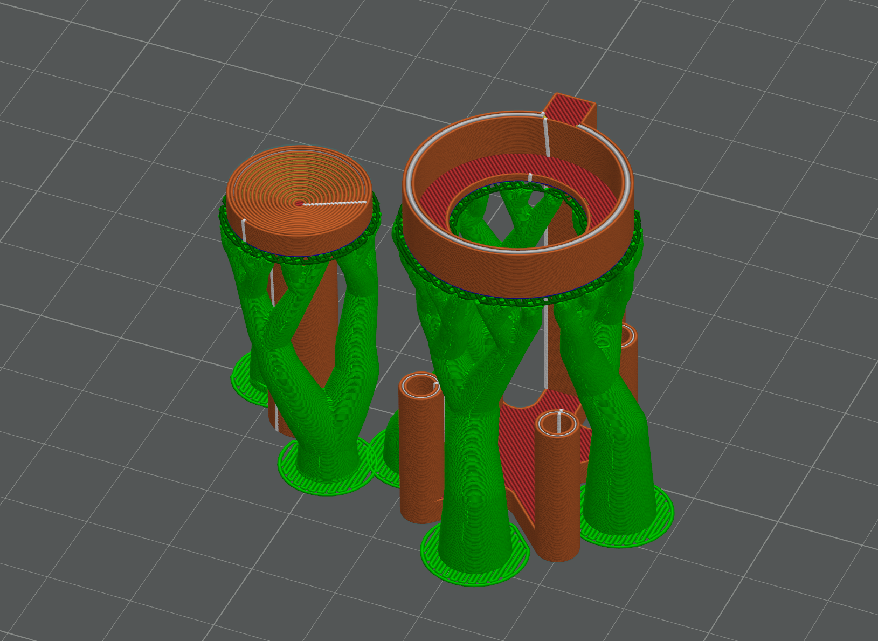
cad/referencias/rodamiento_608_as5600/print example.png
