Nocudo/Pendulo-Furuta-Control-Digital/cad/05_caja_esp32/components/SHIELD_ESP32_TERMINAL_BLOCK.kicad_pcb

## KiCad design cad/05_caja_esp32/components/SHIELD_ESP32_TERMINAL_BLOCK.kicad_pcb (2026-11-11)

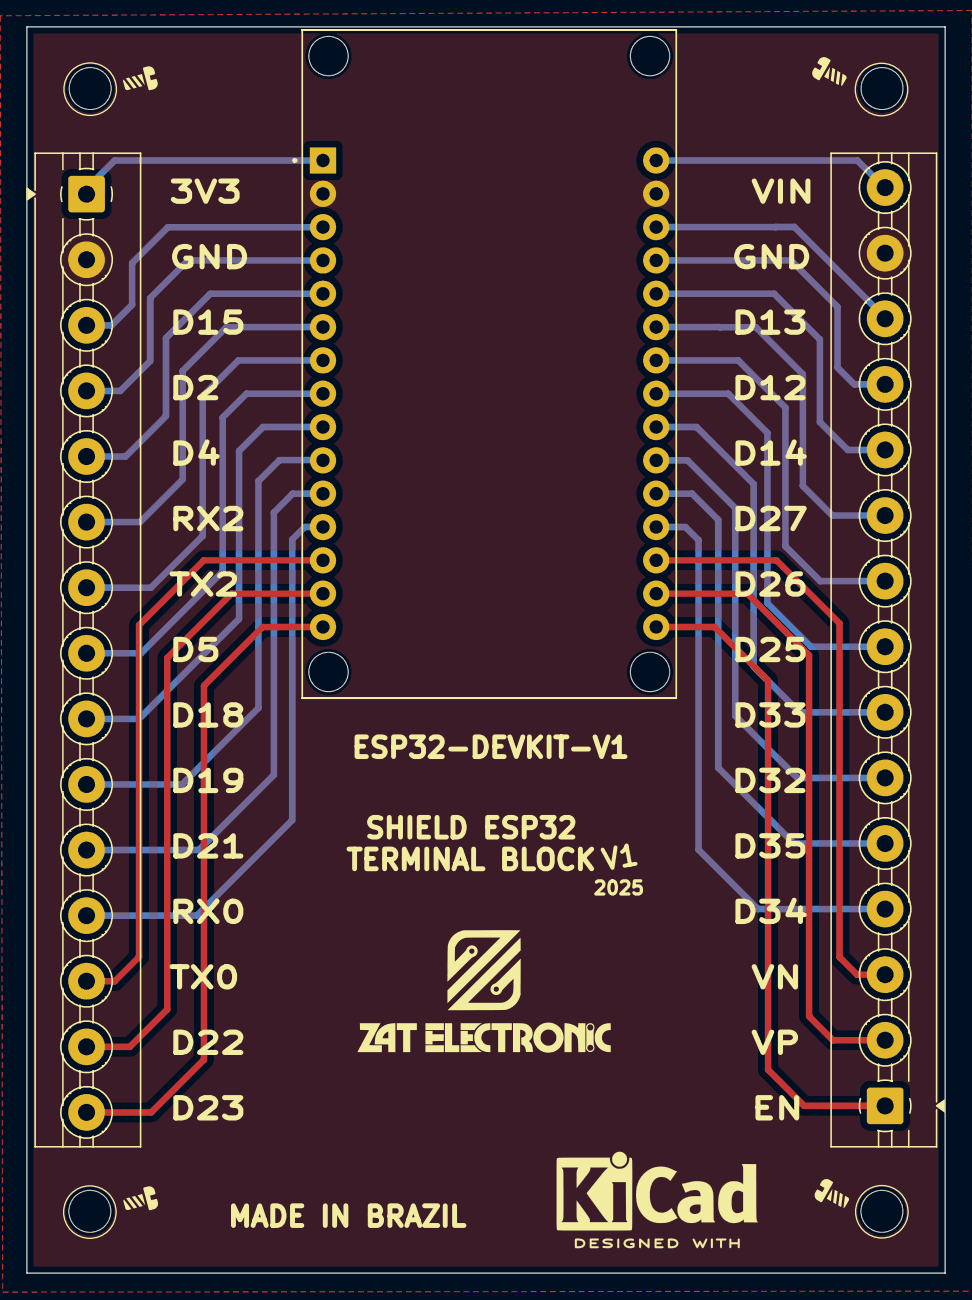
[picture p78: board SHIELD_ESP32_TERMINAL_BLOCK.kicad_pcb from above]

Board: 2 copper layers, 70.0 x 95.0 mm, 7 parts (0 on the bottom side), 29 nets.

Parts:
H1, H2, H3, H4: MountingHole; MountingHole_3.2mm_M3_ISO14580
J1, J2: Conn_01x15; TerminalBlock_MaiXu_MX126-5.0-15P_1x15_P5.00mm
U1: ESP32-DEVKIT-V1; MODULE_ESP32_DEVKIT_V1

Connections:
3V3: J1.1, U1.1 (3V3)
D2: J1.4, U1.4 (D2)
D4: J1.5, U1.5 (D4)
D5: J1.8, U1.8 (D5)
D12: J2.12, U1.27 (D12)
D13: J2.13, U1.28 (D13)
D14: J2.11, U1.26 (D14)
D15: J1.3, U1.3 (D15)
D18: J1.9, U1.9 (D18)
D19: J1.10, U1.10 (D19)
D21: J1.11, U1.11 (D21)
D22: J1.14, U1.14 (D22)
D23: J1.15, U1.15 (D23)
D25: J2.8, U1.23 (D25)
D26: J2.9, U1.24 (D26)
D27: J2.10, U1.25 (D27)
D32: J2.6, U1.21 (D32)
D33: J2.7, U1.22 (D33)
D34: J2.4, U1.19 (D34)
D35: J2.5, U1.20 (D35)
EN: J2.1, U1.16 (EN)
GND: J1.2, J2.14, U1.2 (GND), U1.29 (GND)
RX0: J1.12, U1.12 (RX0)
RX2: J1.6, U1.6 (RX2)
TX0: J1.13, U1.13 (TX0)
TX2: J1.7, U1.7 (TX2)
VIN: J2.15, U1.30 (VIN)
VN: J2.3, U1.18 (VN)
VP: J2.2, U1.17 (VP)
