Nocudo/Pendulo-Furuta-Control-Digital/(commit log)

2026-11-11 cad: péndulo Furuta, motor AS5600, referencias e impresión 3D
    [22CL-3501PG.SLDASM, 22CL_3501PG_Motor.FCStd, AS5600.SLDASM, AS5600_Testing_Stand.FCStd, AS5600_Testing_Stand_Clean.FCStd, AS5600_Testing_Stand_Clean.step, ASSembly.SLDASM, ASSembly.STEP]
2026-11-11 cad: cajas Nucleo-F446RE, driver L298N y ESP32
    [15-Pin Header - Female - 2.54mm.step, 3D_ESP32_Breakout_V2.step, BarrelJack.step, Caja_Base_ESP32.step, Caja_Base_ESP32.stl, Caja_Base_L298N.step, Caja_Base_L298N.stl, Caja_Base_Nucleo.step]
2026-11-11 chore: ignorar directorio local de engram
2026-11-11 fix(3mf): corregir offset vertical Z para asentar piezas en la cama de impresión
    [Placa_1_Torre_Motor_y_Tapa.3mf, Placa_2_Brazo_Barra_y_Masas.3mf, Placa_3_Precision_Encoder_AS5600.3mf, Placa_4_Cajas_Control_Nucleo_L298N.3mf, Placa_5_Opcional_Caja_ESP32.3mf]
2026-11-12 feat(impresion3d): reorganizar en 6 placas optimizadas (torre sola, tapa en placa 2 y cajas independientes)
    [Placa_1_Torre_Motor.3mf, Placa_1_Torre_Motor_y_Tapa.3mf, Placa_2_Brazo_Barra_y_Masas.3mf, Placa_2_Brazo_Barra_y_Tapa.3mf, Placa_3_Precision_Encoder_AS5600.3mf, Placa_4_Caja_Nucleo.3mf, Placa_4_Cajas_Control_Nucleo_L298N.3mf, Placa_5_Caja_L298N.3mf]
2026-11-12 feat(cad): dividir Base_Torre_Furuta en base inferior y torre superior con acople coaxial DfAM y 7 placas Anycubic Kobra 2
    [Barra_Pendulo_Furuta.step, Base_Inferior_Torre_Furuta.step, Base_Inferior_Torre_Furuta.stl, Base_Torre_Furuta.step, Brazo_Horizontal_L88.step, Eje_Portaiman_Pendulo.step, Masa_Ajustable_Pendulo.step, Pendulo_Furuta_Assembly.step]
2026-11-12 fix(cad): rediseñar Torre_Superior_Motor_Furuta para impresion boca abajo sin soportes con arcos ojivales a 37.8°
    [Barra_Pendulo_Furuta.step, Base_Inferior_Torre_Furuta.step, Base_Torre_Furuta.step, Brazo_Horizontal_L88.step, Eje_Portaiman_Pendulo.step, Masa_Ajustable_Pendulo.step, Pendulo_Furuta_Assembly.step, Pendulo_Furuta_Assembly.stl]
